S9-Engineering/samsung-t-series-bay/README.md

# S9 Monolith Bay — DIY 3D-Printable SSD Enclosure

### For Samsung T7, T7 Shield and T9

**Build your own** compact three-drive desktop SSD bay. Download the **STL and 3MF files**, 3D print the PLA parts and assemble an enclosure for **Samsung T7, T7 Shield and T9**, with interchangeable cartridges, passive ventilation and rear cable access.

<!-- project-version:start -->
**Version v1.0.2 · PLA · 8 printed components**
<!-- project-version:end -->

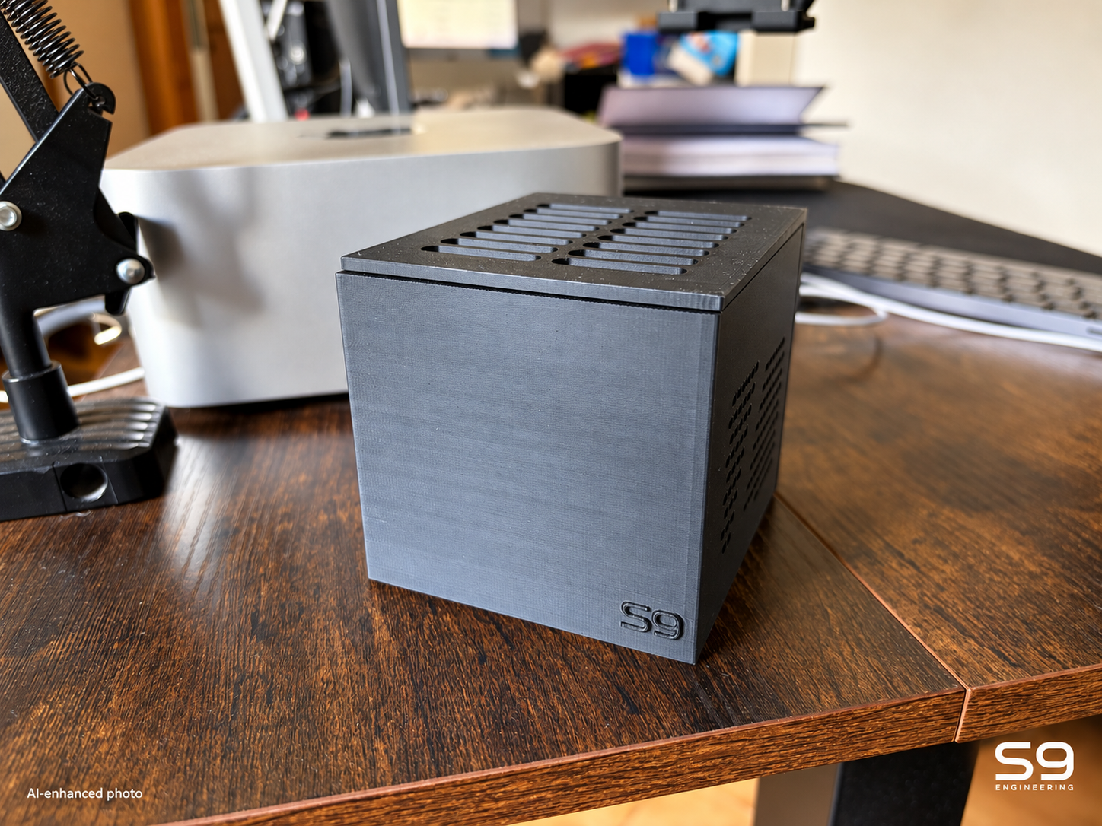
[picture p1: previews/photos/edited/bay-closed-enhanced.png]
Real printed S9 Monolith Bay closed on a wooden desk


*Photograph of the actual print, enhanced with AI for lighting and presentation. S9 Engineering signature at bottom right; “AI-enhanced photo” disclosure at bottom left.*

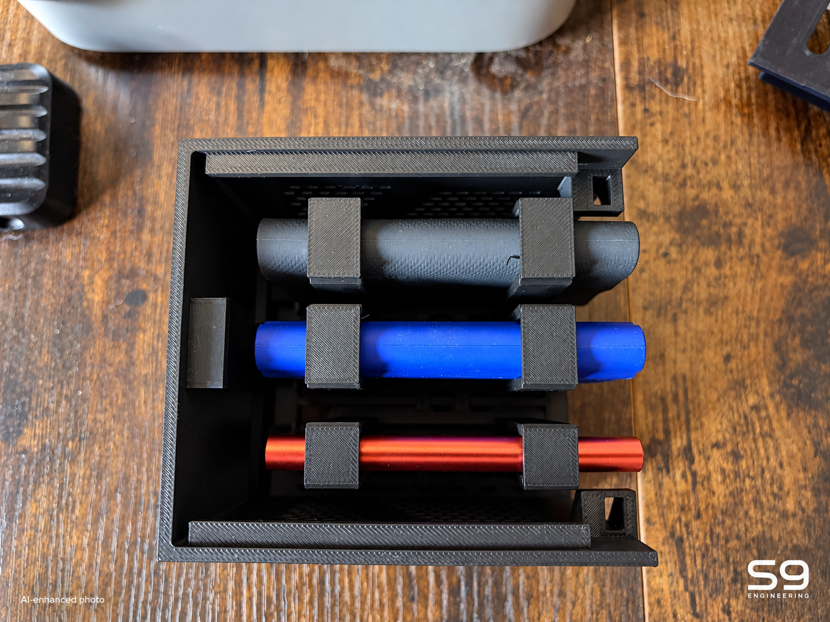
[picture p2: previews/photos/edited/bay-open-enhanced.png]
Actual open bay with three SSDs in their cartridges


*The photographed open enclosure with three installed SSDs. Lighting and presentation enhanced with AI; this is a physical sample rather than a generated product render.*

### Real-print reference photographs

All six photographs below show the author's actual print, with **no generative retouching**. These gallery copies preserve the original framing and printing details; full-resolution JPEG references are included in the repository. Location metadata has been removed from public copies.

| Closed bay | Open top view | Side ventilation |
| --- | --- | --- |
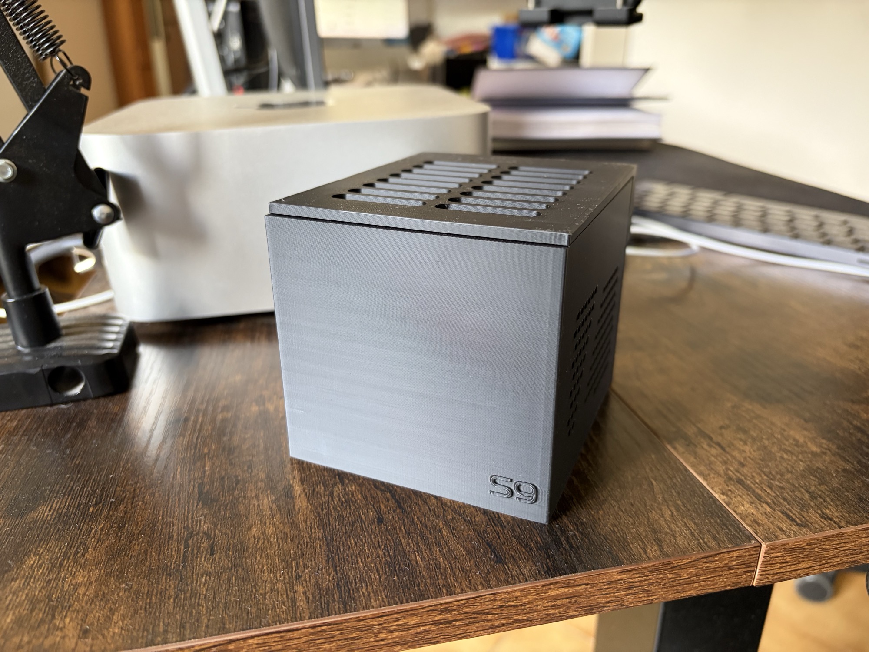
[picture p3: previews/photos/gallery/bay-closed.jpg]
Unretouched real print, closed
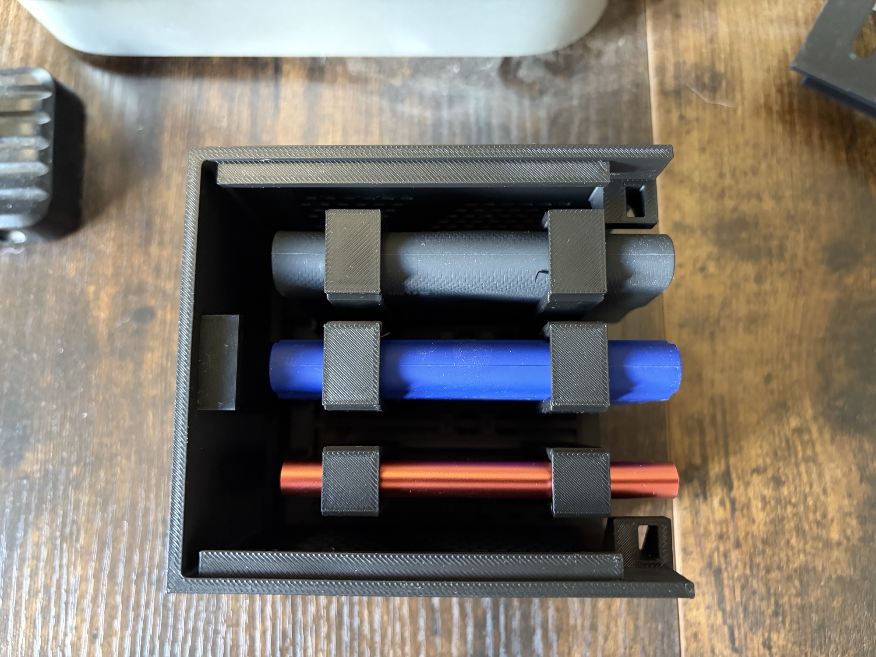
[picture p4: previews/photos/gallery/bay-open.jpg]
Unretouched real print, open
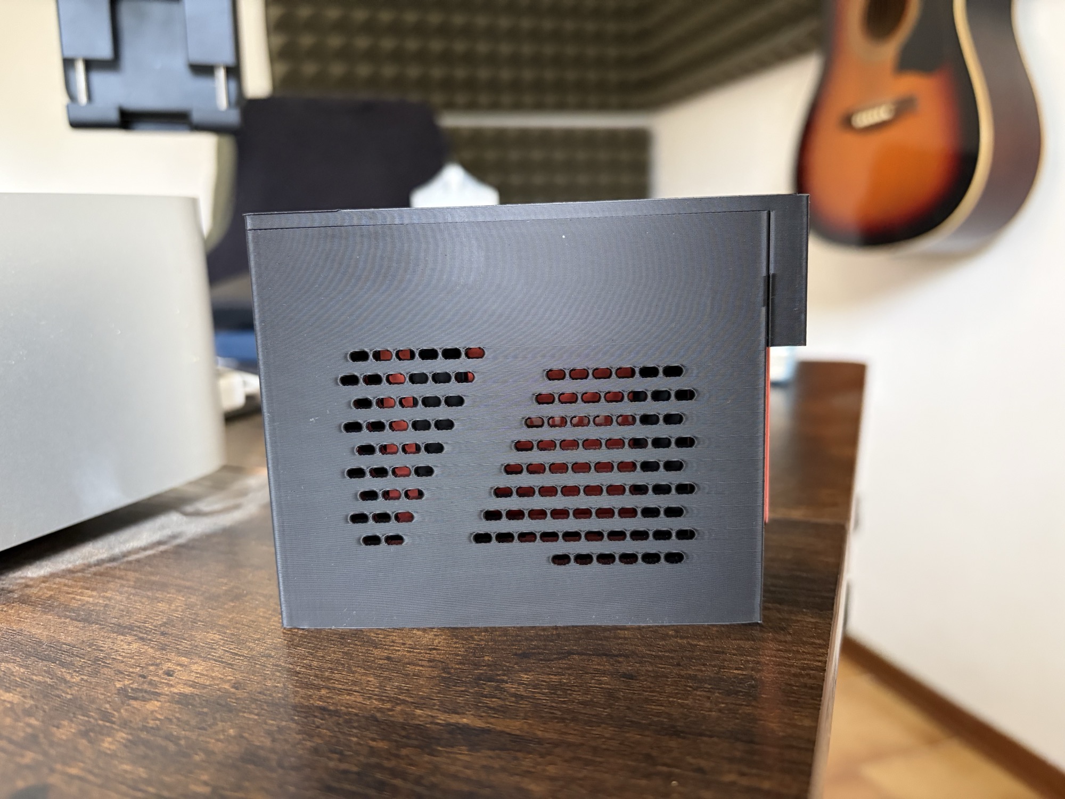
[picture p5: previews/photos/gallery/bay-side.jpg]
Real side ventilation
|  |  |  |

| Rear USB access | Open bay from the rear | Cartridge and stop detail |
| --- | --- | --- |
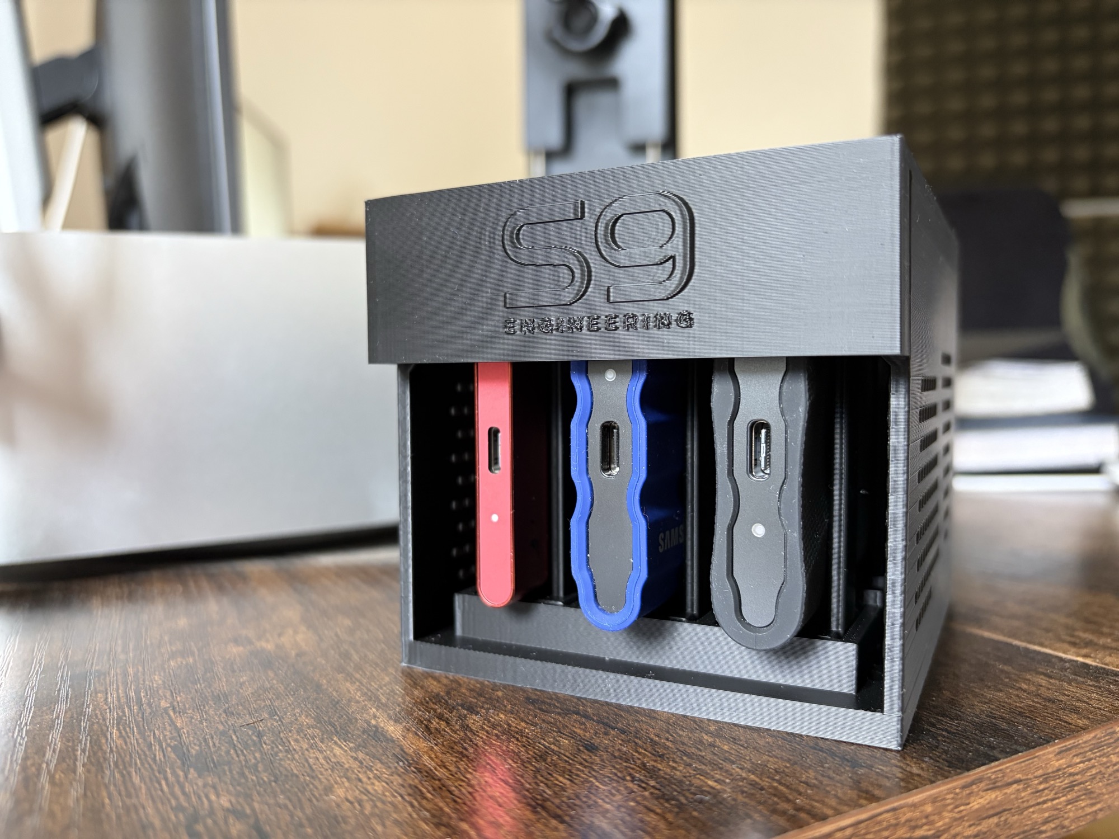
[picture p6: previews/photos/gallery/bay-rear.jpg]
Rear of the printed sample with its earlier branded lid
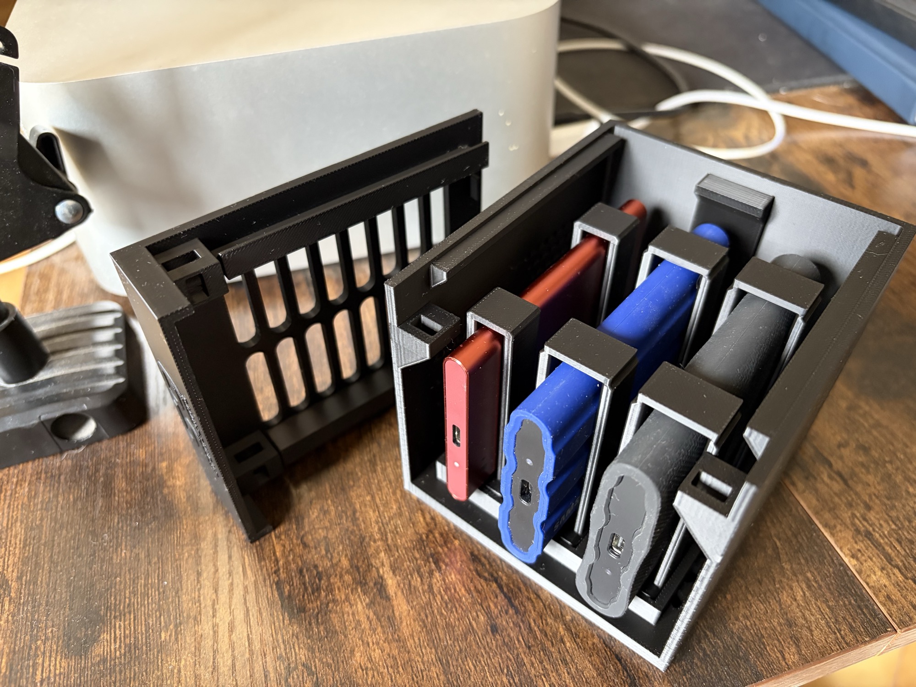
[picture p7: previews/photos/gallery/bay-open-rear.jpg]
Three SSDs and the removed lid
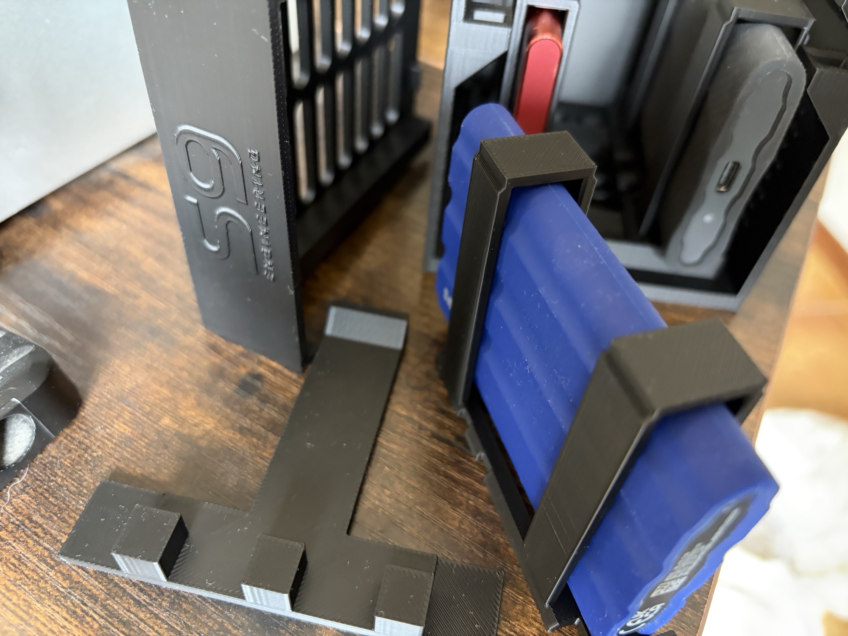
[picture p8: previews/photos/gallery/bay-cartridge-detail.jpg]
Blue SSD cartridge and the common three-block stop
|  |  |  |

*The photographed sample retains the earlier raised S9 Engineering rear lettering; the current downloadable lid has a plain rear tail.*

[Full-resolution photographs and enhanced alternatives](previews/photos/README.md) · [Photo treatment and provenance](previews/photos/edits.json).

## Product views

The following CAD illustrations show the current model and cable opening.

| Front | Side | Rear and cable access |
| --- | --- | --- |
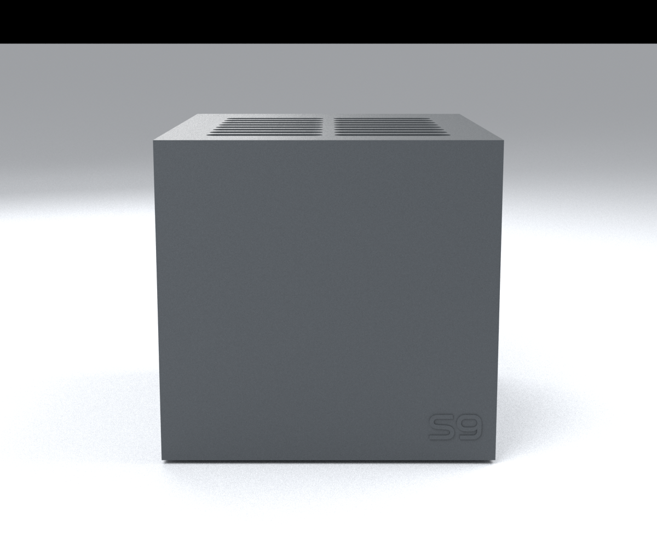
[picture p9: previews/renders/product-front.png]
Front with raised S9
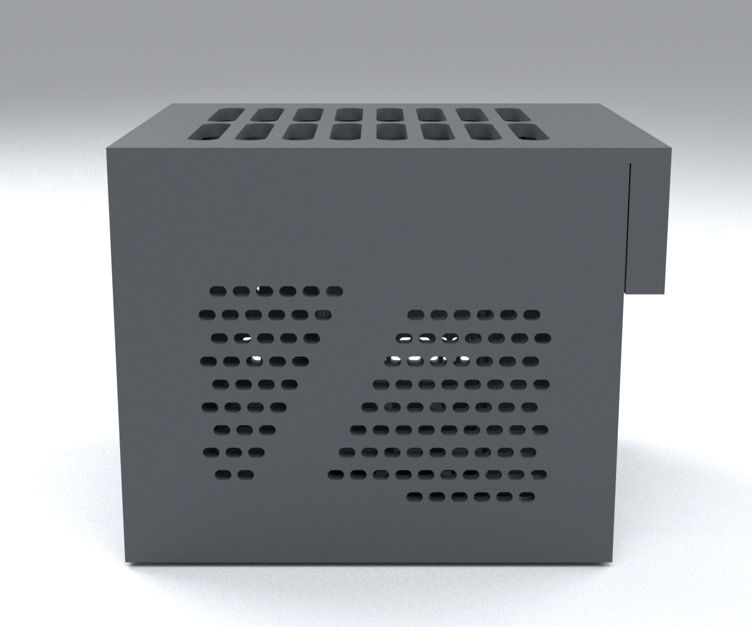
[picture p10: previews/renders/product-side.png]
Horizontal side ventilation
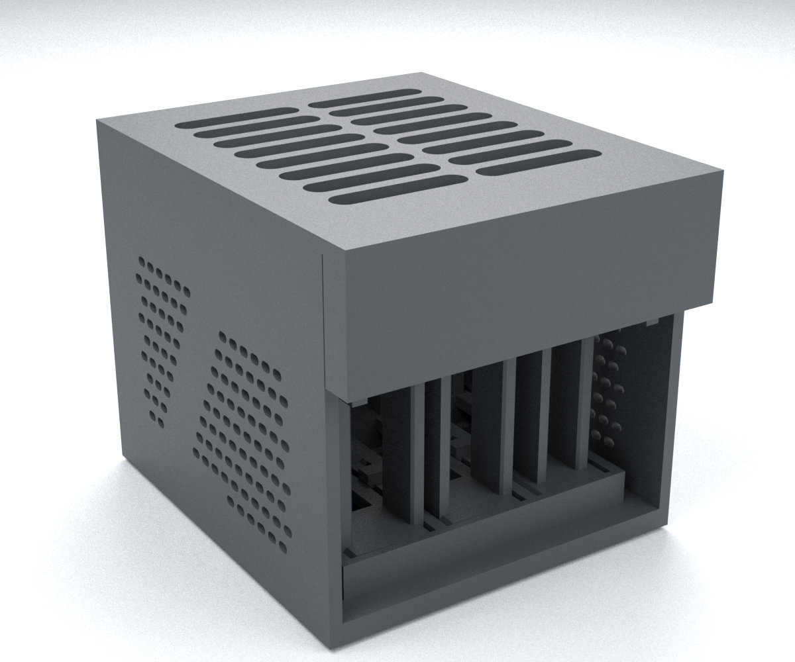
[picture p11: previews/renders/product-rear.png]
Plain rear tail and lower cable opening
|  |  |  |

## Compatibility and specifications

| Samsung portable SSD | Length × height × thickness | Cartridge |
| --- | --- | --- |
| **T7** | 85 × 57 × 8 mm | T7 cartridge included |
| **T7 Shield** | 88 × 59 × 13 mm | T7 Shield cartridge included |
| **T9** | 88 × 60 × 14 mm | T9 cartridge included |

Three drives stand side by side on their long edges, with their USB ports facing the open rear. Each of the three base positions accepts any of the included model-specific cartridges. The complete kit supplies one cartridge for each model above.

- **Overall size:** 90 × 109.4 × 86 mm (width × depth × height), excluding feet and external cables.
- **Enclosure:** sharp-edged monolithic shell, flat slotted roof and horizontal side ventilation pattern.
- **Cooling:** passive ventilation through the base, sides and top. Four rubber feet keep the bottom air inlets clear.
- **Access:** sliding roof on rigid guides, secured by two hidden quarter-turn pins. USB plugs and cable bends remain outside the enclosure.
- **Branding:** raised S9 on the front, 0.4 mm relief; plain rear tail.

## What you need

### For printing

- PLA filament in your chosen colour.
- Flush cutters or a deburring tool for removing the brim.

### For assembly

**8 printed components:**

| Printed component | Quantity | Print orientation / setting | STL |
| --- | ---: | --- | --- |
| Shell | 1 | Upright; 4 walls | [shell.stl](print/stl/shell.stl) |
| Sliding lid with rear tail | 1 | Exterior on the build plate; Arachne | [lid.stl](print/stl/lid.stl) |
| Hidden locking pin | 2 | Flat; 100% rectilinear infill | [locking-pin.stl](print/stl/locking-pin.stl) |
| Common front cartridge stop | 1 | Flat front face on the plate, three blocks up; 4 walls | [cartridge-stop.stl](print/stl/cartridge-stop.stl) |
| T7 cartridge | 1 | Upright frames; 6 walls | [cartridge-t7.stl](print/stl/cartridge-t7.stl) |
| T7 Shield cartridge | 1 | Upright frames; 6 walls | [cartridge-t7-shield.stl](print/stl/cartridge-t7-shield.stl) |
| T9 cartridge | 1 | Upright frames; 6 walls | [cartridge-t9.stl](print/stl/cartridge-t9.stl) |

| Additional item | Quantity | Specification |
| --- | ---: | --- |
| Rubber feet, including transparent types | 4 | Base fitting the Ø10.5 × 0.65 mm underside recesses, with enough projection to leave **at least 5 mm of air below the bay**. A nominal 6 mm foot height is a starting selection; match the actual foot to the recess. |
| Samsung SSDs | Up to 3 | T7, T7 Shield or T9, using the corresponding cartridge. |
| USB cables | One per drive | Matching cables for your SSDs and host, connected from the rear. |

For this replacement, reuse your existing feet, SSDs and cables; no new purchased fittings are needed. PLA BASIC is already in the author’s inventory. [Component sourcing checked 2026-10-25](verification/component-sourcing.json) records the current search limits; no dimensionally verified Amazon.it foot listing was found, so no substitute foot is endorsed.

Assembly is tool-free. There are **no screws, nuts, threaded inserts or internal adhesives**. If you choose self-adhesive rubber feet, their adhesive stays in the four exterior underside recesses. Feet, drives and cables are supplied separately; there is no internal USB hub.

## Download STL and 3MF files

1. Open [GitHub Releases](https://github.com/S9-Engineering/samsung-t-series-bay/releases) and choose the latest release. The current files also live in [print](print) and the [current print package](packages/monolith-bay-print-pack.zip).
2. Under **Assets**, download `monolith-bay-print-pack.zip` and `SHA256SUMS.txt`. Extract the ZIP and read its version-specific `README.md`. Use the matching complete file set. The original v1.0.0 release uses its original versioned asset names.
3. Import the [separate STLs](print/stl) into your slicer in **millimetres**, keeping their supplied orientations. Use the quantities listed above, including **two copies of the locking pin**.
4. Arrange the parts for your build plate, apply your printer and PLA profile with the part settings below, and inspect the slicing preview. The supplied [reference 3MF](print/slicer/full-kit-ecc2-pla-basic.3mf) already contains the one-plate layout and configuration described in **My setup**.
5. Print the parts, let the plate cool, and remove the brim and stray strings from the guides, cartridge openings and pin seats.

The full-kit and replacement 3MF files are complete native slicer projects with saved profiles, object overrides and sliced paths. Its optional G-code in `print/gcode/` is tied to the reference configuration below. Use the separate STLs to slice for your own equipment.

Before extraction, verify the downloaded ZIP with `shasum -a 256 -c SHA256SUMS.txt` from the download directory. Inside the extracted folder, the included `SHA256SUMS.txt` verifies the individual files with the same command. Earlier versions remain available on the Releases page with their original files.

### Replace only the stop and lid

If you already printed v1.0.0, reuse its shell, all cartridges and both pins. Choose one of these alternative layouts; printing all of them would duplicate parts.

| Layout | Native 3MF | Reference slicer estimate |
| --- | --- | --- |
| Stop only | [stop-ecc2-pla-basic.3mf](print/slicer/stop-ecc2-pla-basic.3mf) | 31 min 23 s / 9.54 g |
| Plain rear lid only | [lid-ecc2-pla-basic.3mf](print/slicer/lid-ecc2-pla-basic.3mf) | 2 h 11 min 19 s / 39.58 g |
| Stop and lid together | [both-ecc2-pla-basic.3mf](print/slicer/both-ecc2-pla-basic.3mf) | 2 h 40 min 48 s / 48.59 g |

The stop prints flat on its front face with the three blocks facing up. Remove the brim from the contact edges, lower the stop into the existing shell and check that the cartridge tongues remain blocked throughout its small side movement. No new purchased fittings are needed for this update.

## My setup

This is the reference configuration used to prepare the included 3MF and G-code. You can use the separate STLs with your own printer and material profile.

| Item | What I used |
| --- | --- |
| Printer | ELEGOO Centauri Carbon 2 Combo |
| Printer profile | Elegoo Centauri Carbon 2 0.4 nozzle; 256 × 256 mm plate with the profile's excluded corner |
| Nozzle | 0.4 mm |
| Build plate | Textured PEI |
| Filament | ELEGOO PLA BASIC, 1.75 mm, one colour/channel |
| Slicer | ElegooSlicer 1.5.3.5, engine 2.4.2 |
| PLA enclosure setup | Front door open |
| Reference layout | All 8 printed components on one plate |
| Slicer estimate for this setup | 12 h 23 min 19 s / 213.41 g, including brim; one material, no purge tower |

| Print setting | My value |
| --- | --- |
| Layer height | 0.20 mm |
| Walls | 4 general; 6 on the drive cartridges |
| Infill | 20% gyroid; pins 100% rectilinear |
| Wall generator | Arachne on the lid |
| Nozzle / textured PEI bed | 220 °C / 60 °C |
| Volumetric flow limit / bridge speed | 5 mm³/s / 25 mm/s |
| Brim | Outer, 5 mm; 0.10 mm separation |
| Elephant-foot compensation | 0.10 mm |
| Supports / raft / fuzzy skin | Disabled |

The saved project retains the slicer warning `bed_temperature_too_high_than_filament` for the 60 °C bed setup; keep the front door open as listed above. No other slice warning was accepted.

These are the saved reference values. Temperature, flow and the plate layout should follow your own printer/material configuration when you reslice. The time and consumption above are slicer estimates for this setup.

## How to assemble

Gold and blue in the following images distinguish the pieces; the print project uses a single PLA colour. Drive shapes are schematic envelopes.

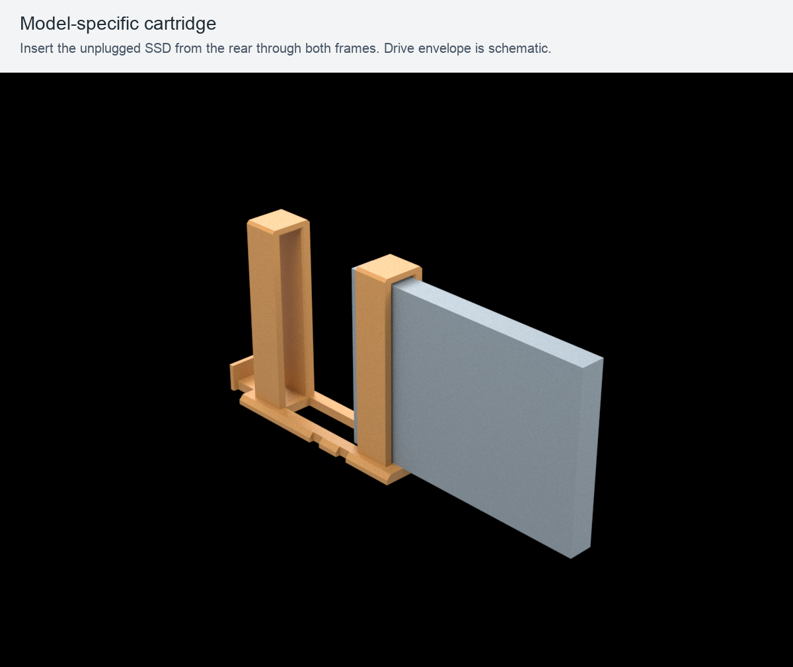
[picture p12: previews/assembly/02-drive-cartridge.png]
Drive entering a model-specific cartridge from the rear


### Load the cartridges

1. With the USB cable unplugged, slide each drive **from the rear through both frames** of its matching cartridge: T7, T7 Shield or T9. The USB port faces the rear.
2. Choose the cartridge's position in the bay. The three base positions share the same interface, so any included cartridge can occupy any position.

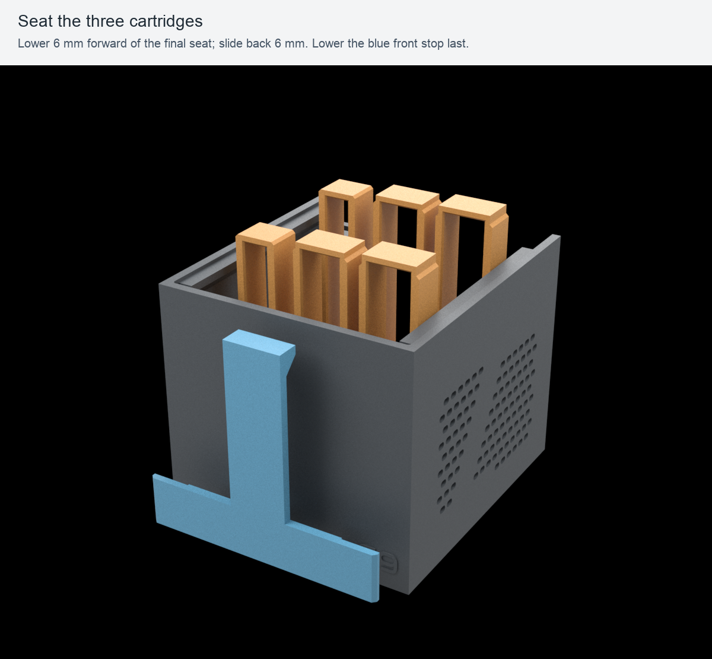
[picture p13: previews/assembly/03-cartridge-seating.png]
Three cartridges and the common front stop above the shell


### Seat the cartridges

3. Hold each cartridge **6 mm forward** of its final position, lower its foot into the base, then slide it **6 mm towards the rear** under the four short rigid tabs.
4. Lower the **83.5 mm common front stop** into the gap between the front wall and the cartridge feet, with its three lower blocks pointing towards the cartridge tongues. It rests on the floor beside the feet; nothing goes underneath them. The nominal side travel is **0.50 mm total**. The added ends clear the internal corner radii and upper roof guides; lift it straight up using the original handle.
5. Fit the four rubber feet in the underside recesses, leaving at least 5 mm of air under the base and keeping the bottom slots unobstructed.

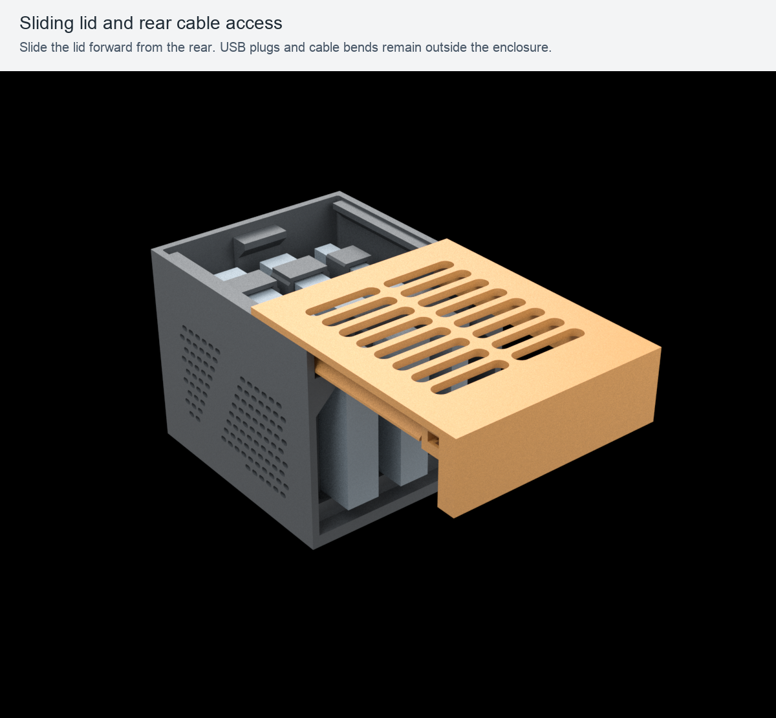
[picture p14: previews/assembly/04-slide-lid.png]
Roof sliding forward along its guides with rear connector access open


### Connect and close

6. Connect the USB cables through the rear opening. Keep the plugs and cable bends outside the enclosure, clear of the rear tail.
7. Slide the lid forward from the rear until fully seated in both guides. Leave approximately **110 mm behind the bay** for roof removal, plus space for the natural cable bend.

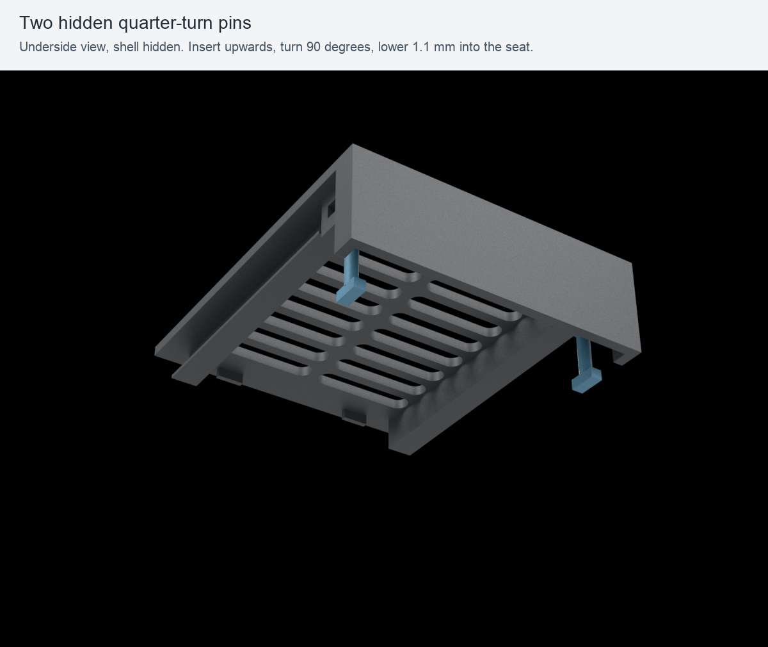
[picture p15: previews/assembly/05-locking-pins.png]
Underside of the lid showing its two hidden locking pins


8. Insert each pin **from below**, turn it **90°**, then lower it **1.1 mm** into its seat. The two receivers are mirrored; turn each pin in the direction that seats its crossbar. Both pins are identical printed parts. The image hides the shell so the locking arrangement is visible.
9. Place the bay upright on the desk with the ventilation openings clear and the cables relaxed.

### Open or remove a drive

10. Lift each pin **1.1 mm**, turn it back and remove it. Remove **both** pins before sliding the roof rearward.
11. Unplug the drive cable, lift the common front stop by its handle, slide the cartridge forward **6 mm**, and lift it out. Slide the drive out of its cartridge from the rear.

## Editable CAD and versioning

The working tree contains one current model family: [STL](print/stl), [STEP](cad), [native print projects](print/slicer), [editable CAD](source/generate.py), [parameters](source/parameters.json) and [verification](verification/geometry.json). Device-specific cartridges are functional variants of the same kit.

`VERSION` is the only project version counter. Every normal push to `main` prepares the next patch version, validates the saved artifact evidence, builds the print ZIP, commits version/package updates, and publishes an immutable matching Git tag and GitHub Release. Set a higher minor/major value in `VERSION` explicitly when needed; no parallel Rxx numbering is used. Source changes without matching regenerated files/evidence fail the release checks. Branch pushes do not release.

Use Git commits for history, branches for development, and tagged releases for distributed kits. Earlier snapshots remain recoverable from Git; published tags and release assets are unchanged. Component files use stable English names. Use all files from the same tag when printing a distributed kit.

```sh
python3.11 -m venv .venv-cad
.venv-cad/bin/pip install -r source/requirements.txt
.venv-cad/bin/python source/generate.py
.venv-cad/bin/python source/verify.py
```

The generator exports assembled and print-oriented STEP files, oriented STL files and an assembly manifest. Printing projects retain their already-checked machine configuration; run `.venv-cad/bin/python source/slice.py` after geometry verification to regenerate the native projects and real G-code. [Geometry checks](verification/geometry.json) also compare the current stop and lid with the accepted cartridge-stop and lid geometry. No thermal or endurance test is claimed.

## License and attribution

Original project designs and documentation are licensed under **CC BY-NC-SA 4.0** ([LICENSE.txt](LICENSE.txt)). Original S9 software, including CAD generators and build/render scripts, is licensed under **PolyForm Noncommercial 1.0.0** ([LICENSE-SOFTWARE.txt](LICENSE-SOFTWARE.txt)). Read [LICENSING.md](LICENSING.md) for scope, required notices, separate commercial permissions, S9 branding and third-party exclusions. The software is source-available; generated models retain their separately stated design license.

The license grants include covered original material in **v1.0.0** and original software in Git history and release source archives. The original published archive predates these notices and remains unchanged; historical statements that no license was selected or software terms were undecided are superseded by the current grants in LICENSING.md. Current print packages include both license texts and the scope notice.

Samsung names identify compatible devices; this is an independent enclosure design with no claim of manufacturer affiliation.
