S9-Engineering/samsung-t-series-bay/previews/photos/prompts.md

# Real-print photo enhancement prompts

Prepared on 2026-10-26 with the built-in image_gen tool. These are edits of supplied photographs, not new product renders. Both covers are disclosed as **AI-enhanced photo**. Full-resolution, unretouched JPEG references are retained alongside the presentation images.

## Closed bay

Use case: lighting-weather. Edit target: image 1, a REAL photograph of a charcoal PLA 3D-printed S9 Monolith Bay on a wooden desk. Image 2 is ONLY the approved S9 Engineering branding reference, never a product reference. Deliver one faithful polished photographic cover at landscape 4:3 aspect ratio. Keep the exact original camera angle, crop, object silhouette and proportions, sharp enclosure corners, lid seam, every top ventilation slot and all side ventilation openings EXACTLY as photographed. Keep the small raised S9 logo on the actual front at its existing size, shape and placement. Preserve all real FDM layer lines, top extrusion lines, minor print imperfections, specks and surface irregularities; do not smooth, retouch, rebuild or redraw the physical object. Make only restrained exposure, white balance and local shadow adjustments so this dark grey printed object reads clearly, without becoming lighter material, metallic or glossy. Keep the original wooden desk, computer, keyboard, blurred room and microphone arm; preserve depth of field and contact shadows. NO new props, NO imaginary SSDs, NO geometry modification, NO beautifying away print defects. At bottom right, in the wooden desk margin clear of the object, add a very small crisp S9 ENGINEERING signature using the exact logo design in image 2 (white artwork only, no rectangular background), with comfortable edge margins. At bottom left add tiny readable text exactly: 'AI-enhanced photo'. The result must remain recognisably this same real photograph, not a CGI reconstruction.

## Open bay

Use case: lighting-weather. Edit target: image 1, a REAL top-down photograph of the open S9 Monolith Bay with three actual SSDs fitted in printed cartridges. Image 2 is ONLY the approved S9 Engineering branding reference. Produce a faithful photographic enhancement, landscape 4:3. Preserve the EXACT original perspective, crop and product pixels' structure: all three actual drives in their current positions and colours (black/grey top, blue middle, slim orange-red bottom); exactly two printed retaining frames around each drive; front wall at left, open cable side at right, both roof guide rails and square receivers at right, common front stop at left. Keep the existing opening count, cartridge frame dimensions, drive edges, printed layer lines and extrusion texture, imperfections, contact shadows and gaps. Never invent a fourth drive, never replace the cartridges, never close the open enclosure or alter a printed part. Adjust only modest exposure, natural white balance and light/shadow clarity. Preserve wooden desktop, out-of-focus items at image borders and realistic camera optics. Do not replace or clean up the physical object's surface, do not create a render. Add a very small white S9 ENGINEERING signature using the supplied exact logo design (no background box) at bottom right on the desk margin, clear of the enclosure, and tiny text 'AI-enhanced photo' at bottom left. Keep both marks subtle with clear edge margins.
