S9-Engineering/samsung-t-series-bay/previews/photos/README.md

# Photographs of the printed S9 Monolith Bay

The author supplied these six real photographs. The reference JPEGs contain no generative retouching: HEIC captures were converted at full resolution, with location metadata removed without changing the JPEG's decoded pixels. The smaller gallery copies retain the full framing at 2000 × 1500 pixels.

| View | Gallery photograph | Full-resolution reference | AI-enhanced alternative |
| --- | --- | --- | --- |
| Closed bay | [View](gallery/bay-closed.jpg) | [JPEG](edited/bay-closed-real.jpg) | [PNG](edited/bay-closed-enhanced.png) |
| Open top view | [View](gallery/bay-open.jpg) | [JPEG](edited/bay-open-real.jpg) | [PNG](edited/bay-open-enhanced.png) |
| Side ventilation | [View](gallery/bay-side.jpg) | [JPEG](edited/bay-side-real.jpg) | [PNG](edited/bay-side-enhanced.png) |
| Rear USB access | [View](gallery/bay-rear.jpg) | [JPEG](edited/bay-rear-real.jpg) | [PNG](edited/bay-rear-enhanced.png) |
| Open rear view | [View](gallery/bay-open-rear.jpg) | [JPEG](edited/bay-open-rear-real.jpg) | [PNG](edited/bay-open-rear-enhanced.png) |
| Cartridge and stop detail | [View](gallery/bay-cartridge-detail.jpg) | [JPEG](edited/bay-cartridge-detail-real.jpg) | [PNG](edited/bay-cartridge-detail-enhanced.png) |

The photographed build retains the earlier raised **S9 Engineering** rear lettering. The current downloadable lid has a plain rear tail. The photographs show that physical sample without altering its components to match a later CAD revision.

## Preservation and treatment

Untouched HEIC captures remain local because they contain GPS coordinates. Their narrow ignore rules keep those files out of public Git history. The full-resolution public JPEGs, gallery copies, enhanced images and [provenance](edits.json) are versioned in this repository.

Enhanced alternatives were prepared with the built-in image tool for restrained lighting and presentation changes, with an S9 Engineering signature and an **AI-enhanced photo** label. Reference photographs retain the actual surface texture and print imperfections. [Initial prompts](prompts.md) and [additional prompts](additional-prompts.json) document the treatments.

Channel-specific exports and upload ZIPs remain local, separate from these GitHub assets.
