S9-Engineering/samsung-t-series-bay/assets/cover-references/closed-cad.png

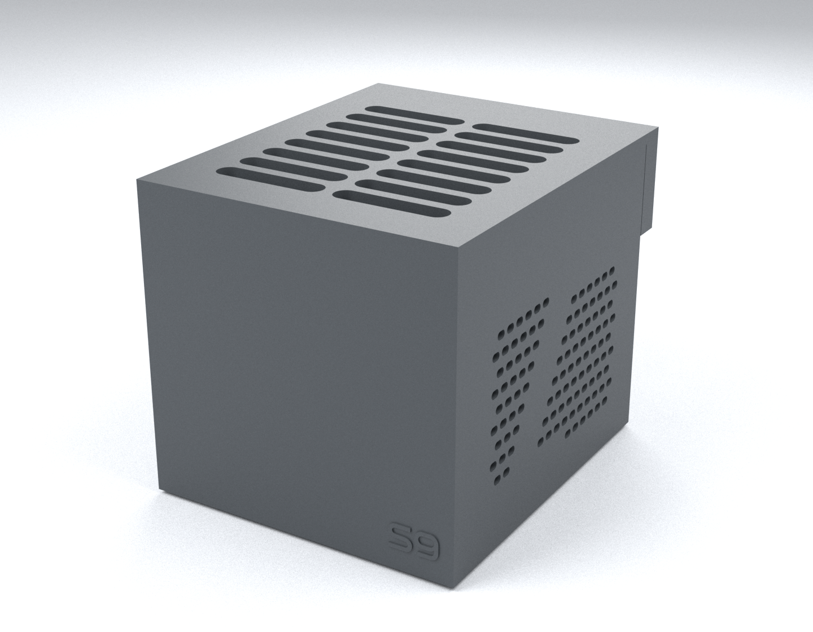
assets/cover-references/closed-cad.png
