S9-Engineering/samsung-t-series-bay/assets/cover-references/open-cad.png

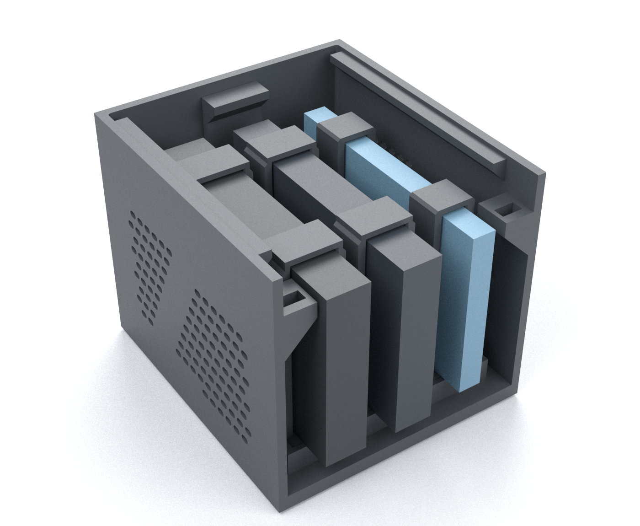
assets/cover-references/open-cad.png
