S9-Engineering/samsung-t-series-bay/assets/cover-references/photoreal-v2-pass1.png

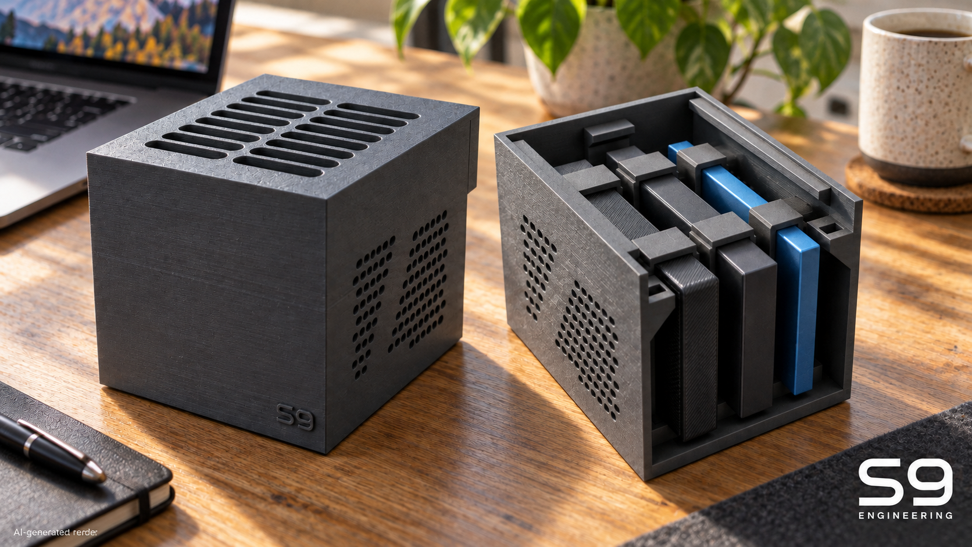
assets/cover-references/photoreal-v2-pass1.png
