S9-Engineering/samsung-t-series-bay/previews/photos/edited/bay-cartridge-detail-enhanced.png

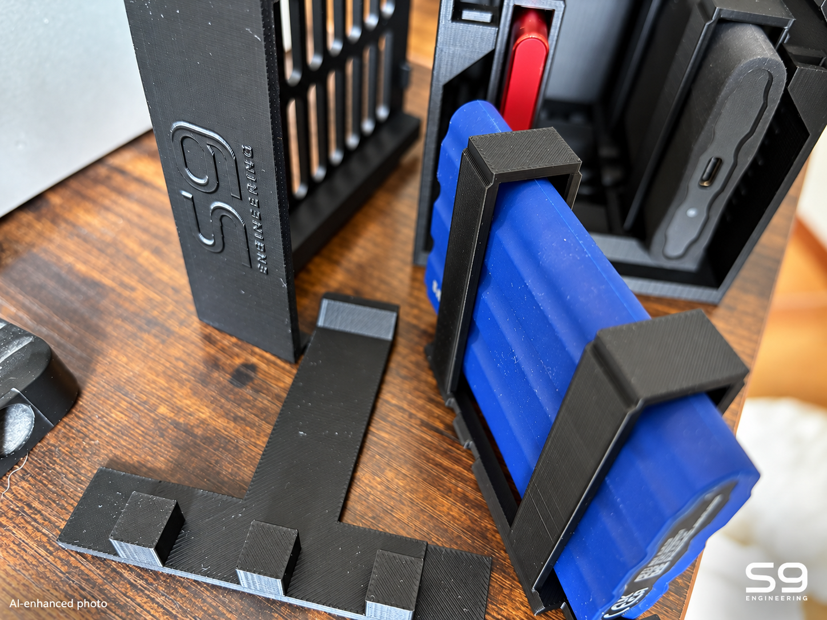
previews/photos/edited/bay-cartridge-detail-enhanced.png
