S9-Engineering/samsung-t-series-bay/previews/photos/edited/bay-rear-enhanced.png

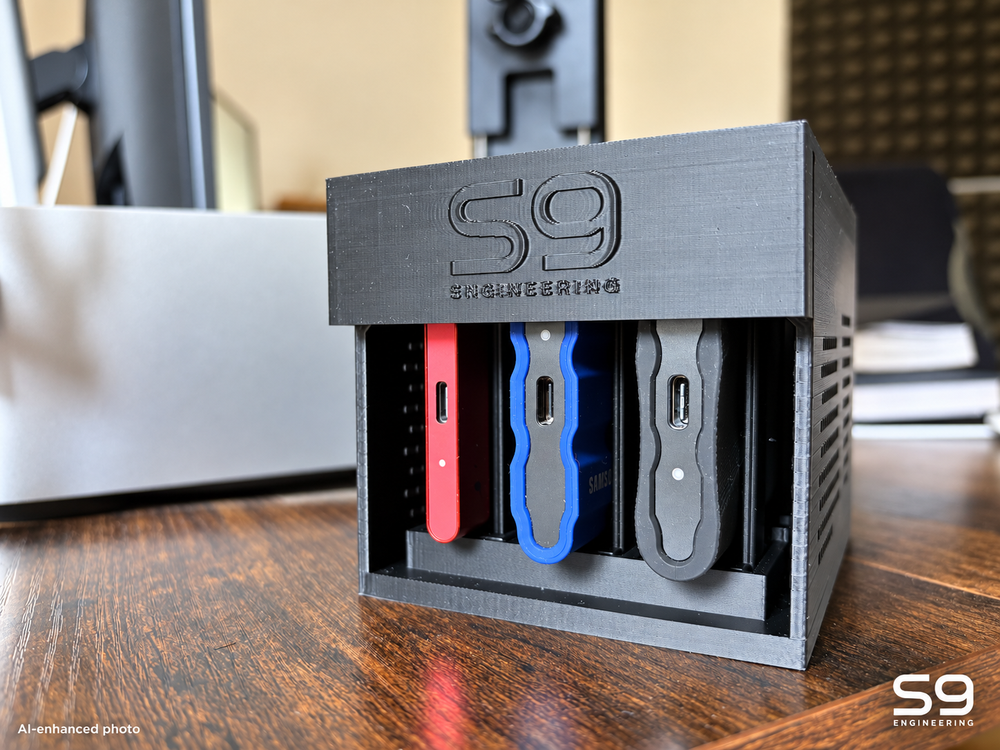
previews/photos/edited/bay-rear-enhanced.png
