S9-Engineering/samsung-t-series-bay/previews/renders/hero-desk-closed-open.png

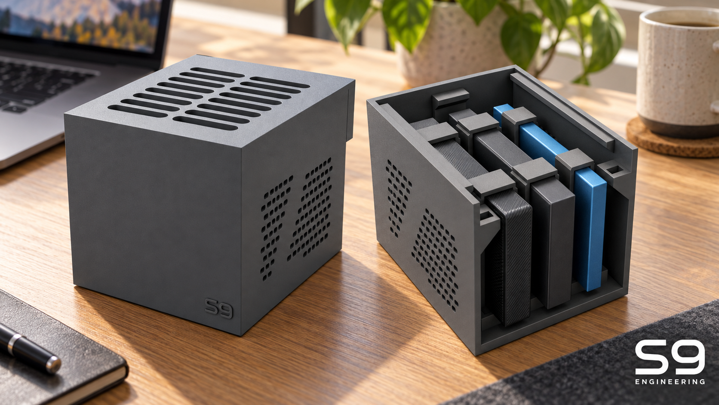
previews/renders/hero-desk-closed-open.png
