S9-Engineering/samsung-t-series-bay/verification/slicing/both/review-overview.png

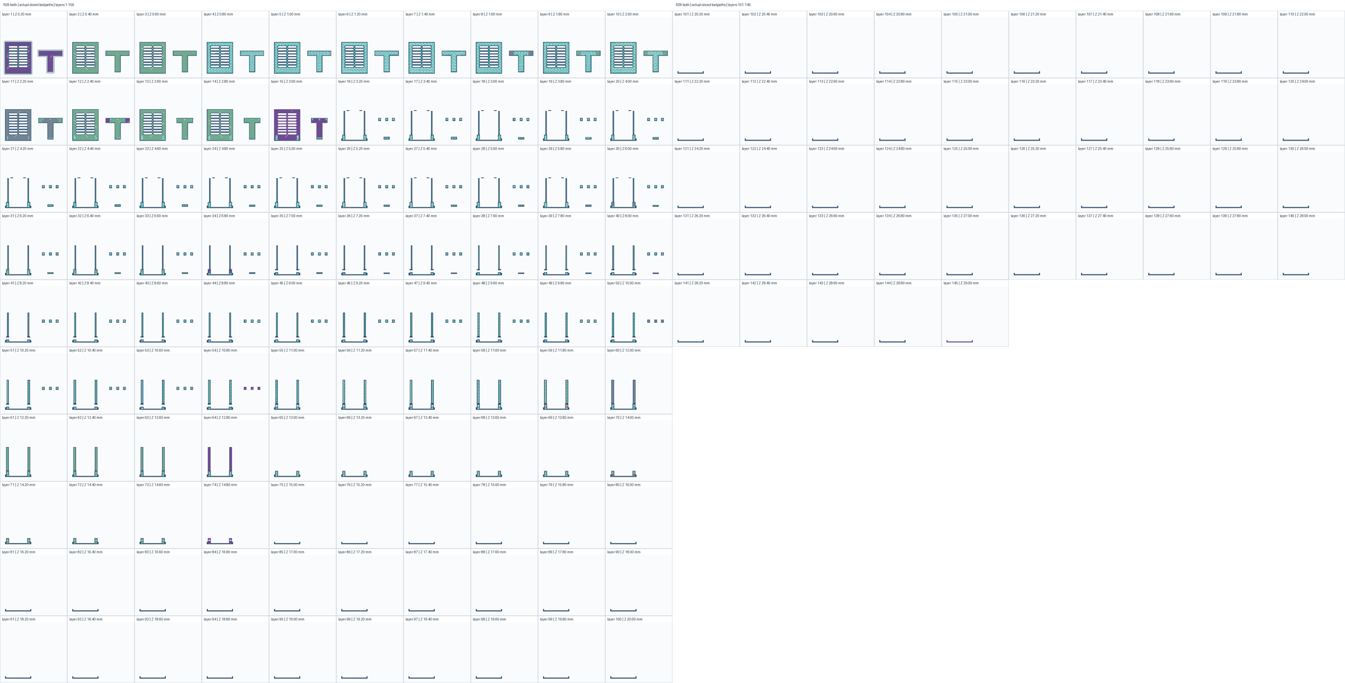
verification/slicing/both/review-overview.png
