S9-Engineering/samsung-t-series-bay/verification/slicing/lid/review-overview.png

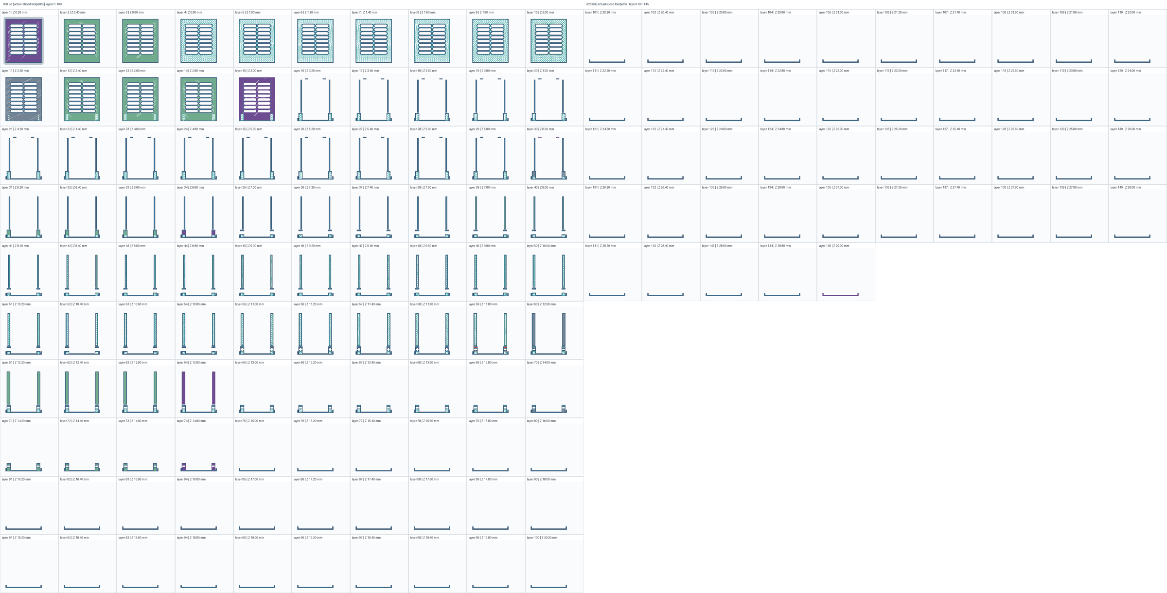
verification/slicing/lid/review-overview.png
