S9-Engineering/samsung-t-series-bay/verification/slicing/stop/review-overview.png

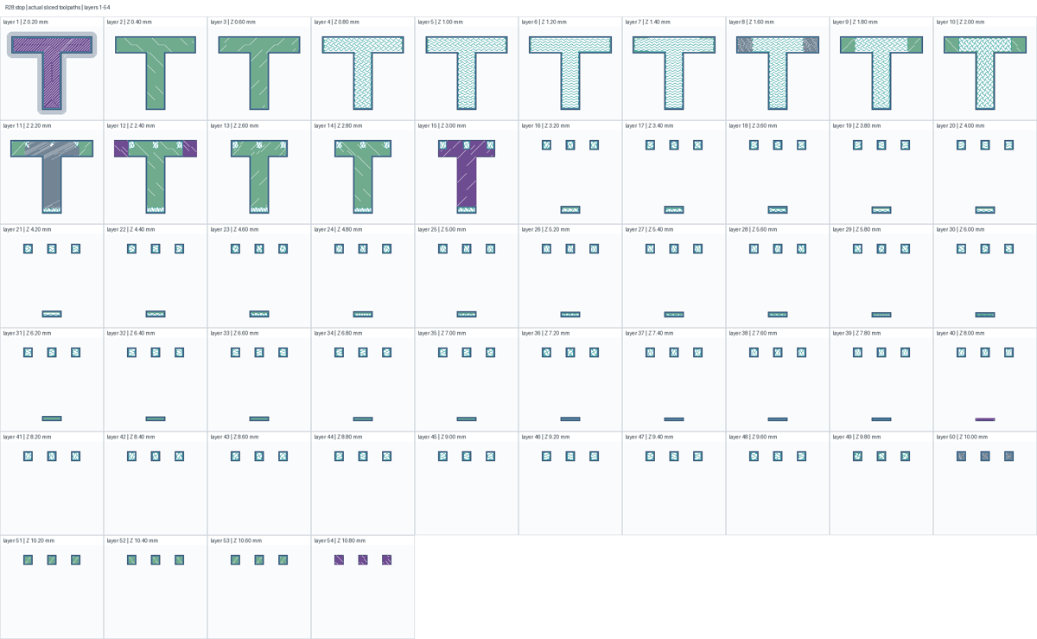
verification/slicing/stop/review-overview.png
