S9-Engineering/samsung-t-series-bay/print/slicer/full-kit-ecc2-pla-basic.3mf

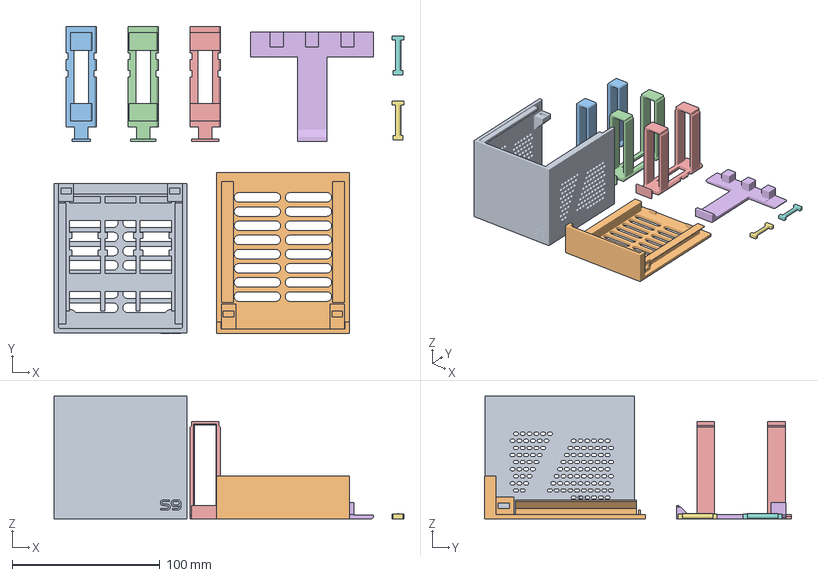
[picture p25: CAD file, 2026-10-25]
print/slicer/full-kit-ecc2-pla-basic.3mf
237.0 x 207.7 x 83.0 mm
Sliding lid
Cartridge t7
Cartridge t7-shield
Cartridge t9
Cartridge stop
Locking pin 1
Locking pin 2
