S9-Engineering/samsung-t-series-bay/cad/reference-assembly-do-not-print.step

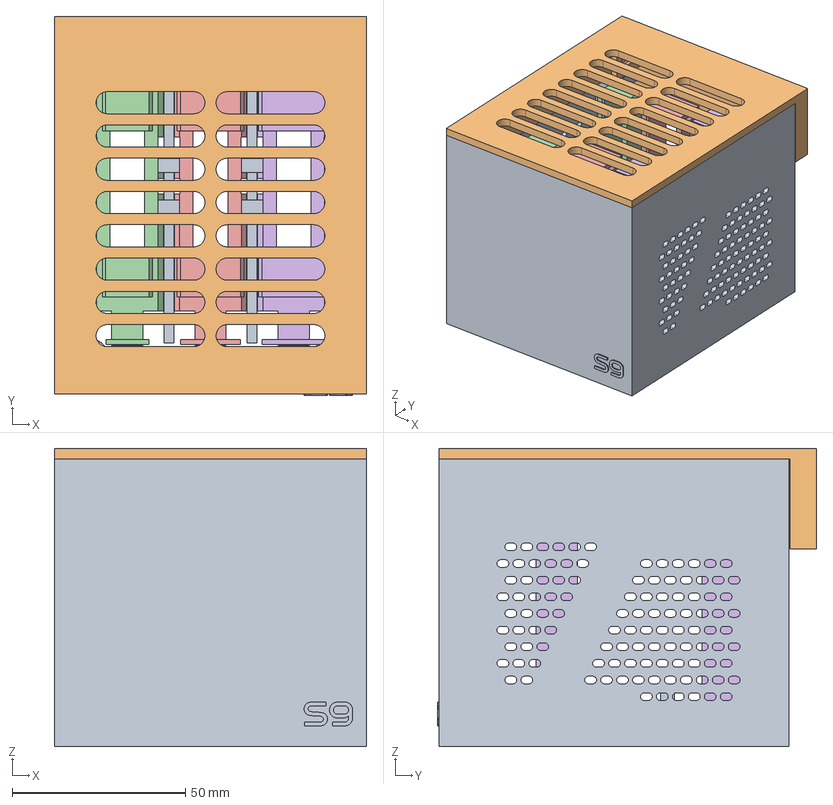
[picture p26: CAD file, 2026-10-25]
cad/reference-assembly-do-not-print.step
90.0 x 109.4 x 86.0 mm
lid
cartridge-stop
cartridge-t7
cartridge-t7-shield
cartridge-t9
locking-pin-1
locking-pin-2
