S9-Engineering/samsung-t-series-bay/cad/locking-pin.step

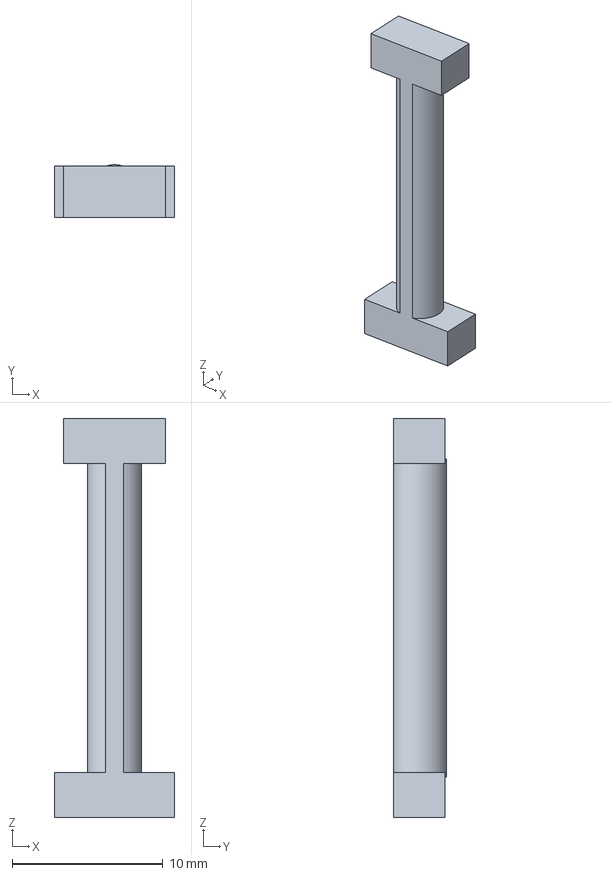
[picture p27: CAD file, 2026-10-25]
cad/locking-pin.step
8.00 x 3.50 x 26.5 mm
