S9-Engineering/samsung-t-series-bay/cad/print/shell.step

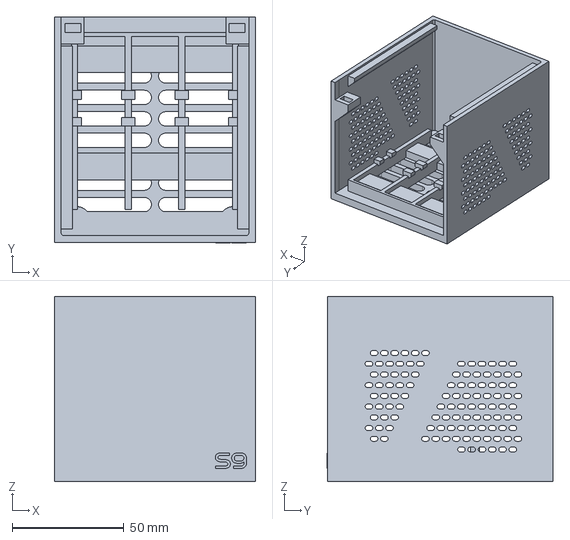
[picture p28: CAD file, 2026-10-25]
cad/print/shell.step
90.0 x 101.4 x 83.0 mm
