S9-Engineering/samsung-t-series-bay/verification/meshes/cartridge-stop.ply

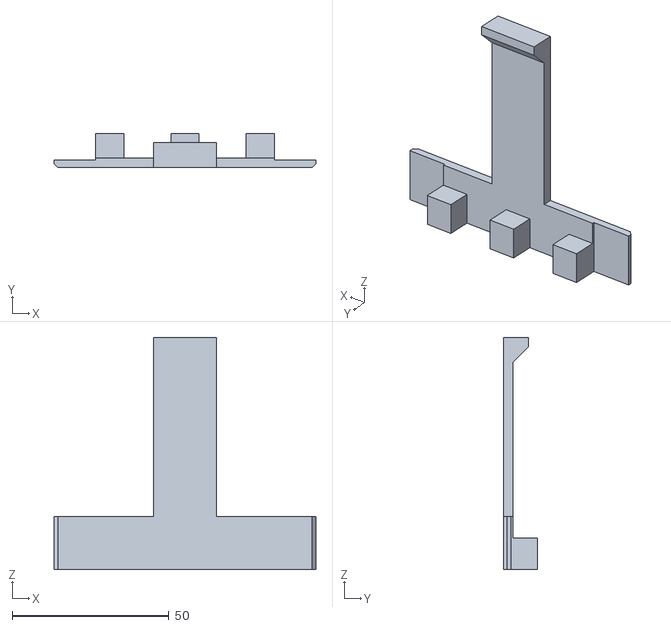
[picture p29: CAD file, 2026-10-25]
verification/meshes/cartridge-stop.ply
83.5 x 10.9 x 74.0
