S9-Engineering/samsung-t-series-bay/verification/slicing/both/both-geometry.3mf

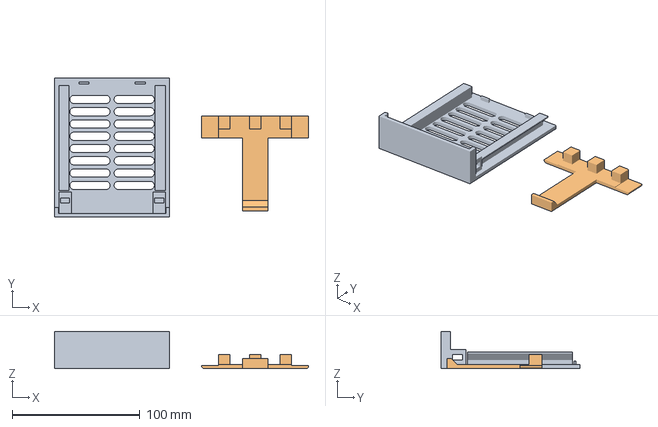
[picture p30: CAD file, 2026-10-25]
verification/slicing/both/both-geometry.3mf
198.5 x 109.0 x 29.0 mm
Sliding lid
Cartridge stop
