S9-Engineering/samsung-t-series-bay/verification/slicing/lid/lid-geometry.3mf

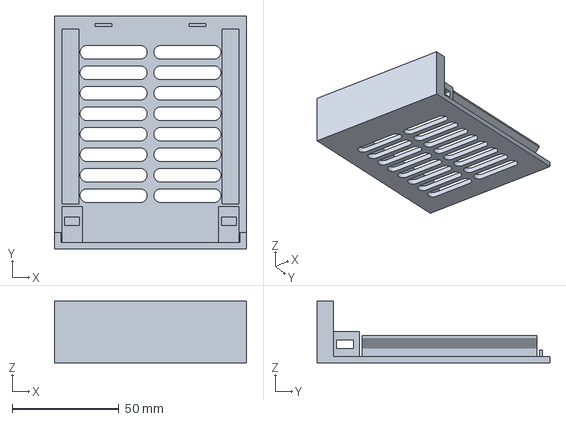
[picture p31: CAD file, 2026-10-25]
verification/slicing/lid/lid-geometry.3mf
90.0 x 109.0 x 29.0 mm
