S9-Engineering/samsung-t-series-bay/cad/cartridge-t9.step

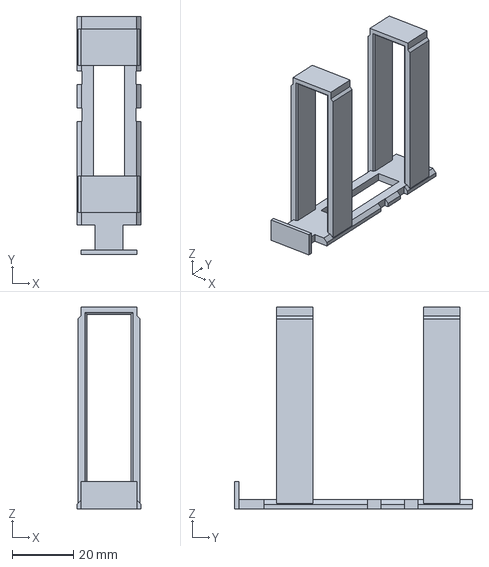
[picture p32: CAD file, 2026-10-25]
cad/cartridge-t9.step
20.8 x 77.7 x 65.9 mm
