S9-Engineering/samsung-t-series-bay/cad/cartridge-t7-shield.step

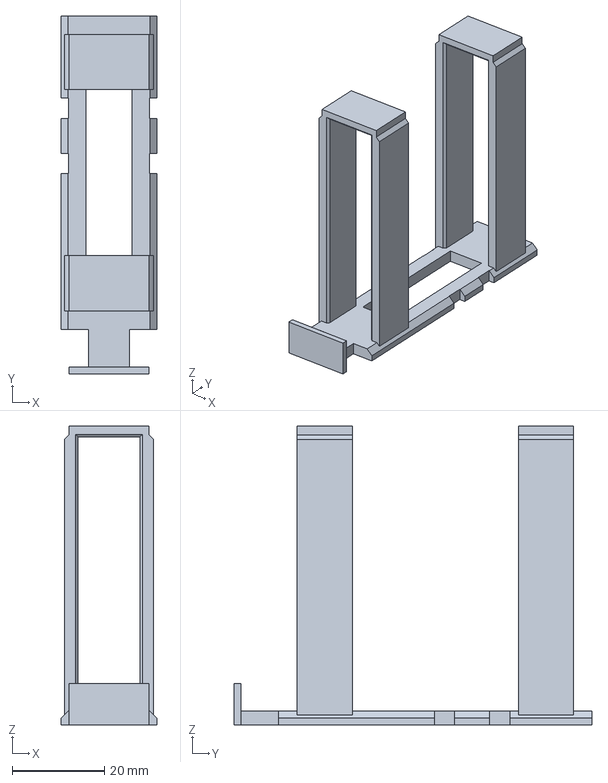
[picture p33: CAD file, 2026-10-25]
cad/cartridge-t7-shield.step
20.8 x 77.7 x 64.9 mm
