S9-Engineering/samsung-t-series-bay/verification/meshes/fit-shell.ply

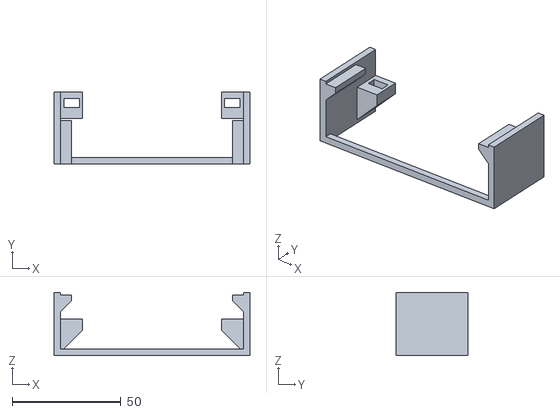
[picture p34: CAD file, 2026-10-24]
verification/meshes/fit-shell.ply
90.0 x 33.0 x 29.0
