S9-Engineering/samsung-t-series-bay/print/slicer/01-fit-coupon-ecc2-pla-basic.3mf

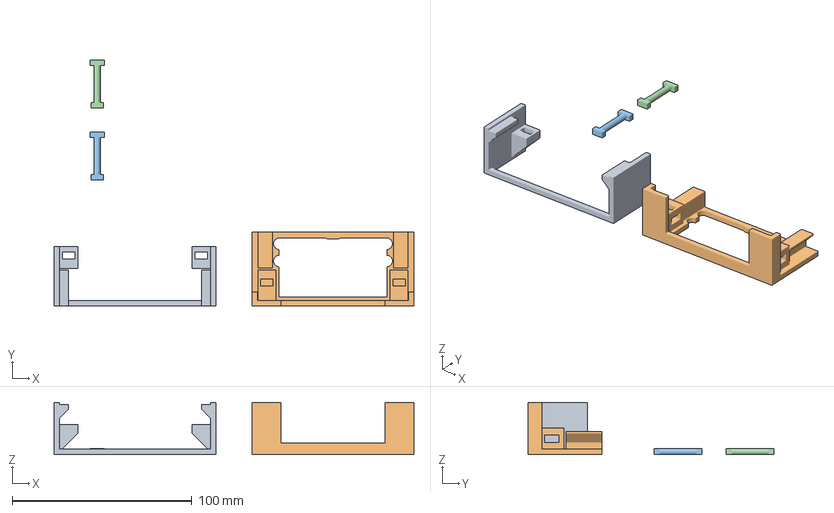
[picture p35: CAD file, 2026-10-24]
print/slicer/01-fit-coupon-ecc2-pla-basic.3mf
200.0 x 136.5 x 29.0 mm
PROVINO_GUIDE_SCOCCA_R27
PROVINO_GUIDE_TETTO_R27
PERNO_R27_SX
PERNO_R27_DX
