S9-Engineering/samsung-t-series-bay/cad/cartridge-t7.step

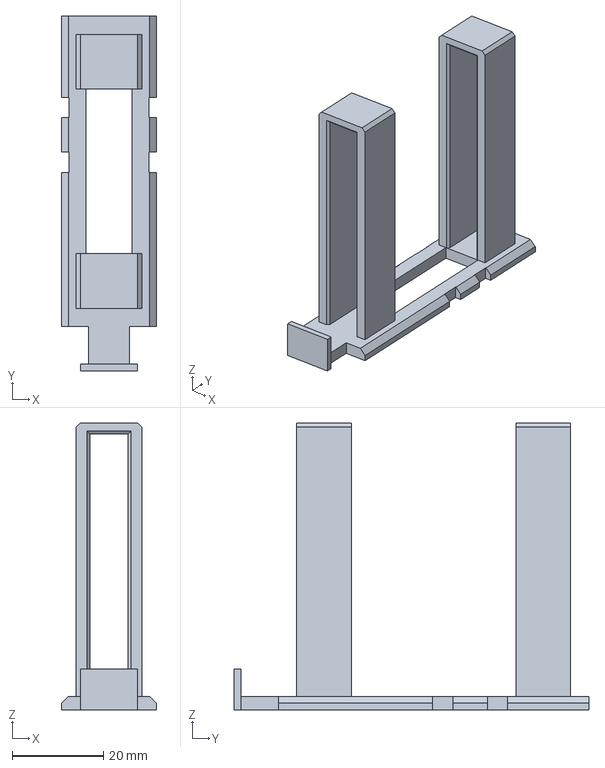
[picture p36: CAD file, 2026-10-25]
cad/cartridge-t7.step
20.8 x 77.7 x 62.9 mm
