S9-Engineering/samsung-t-series-bay/verification/meshes/fit-lid.ply

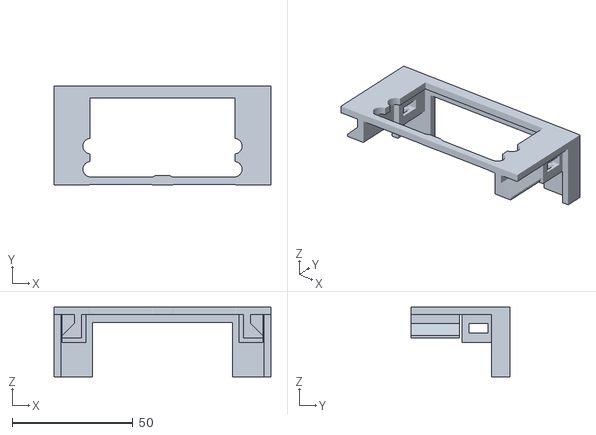
[picture p37: CAD file, 2026-10-24]
verification/meshes/fit-lid.ply
90.0 x 41.0 x 29.0
