S9-Engineering/samsung-t-series-bay/(list of files, cad)

Other CAD files:
verification/slicing/full-kit/full-kit-geometry.3mf
verification/slicing/stop/stop-geometry.3mf
cad/cartridge-stop.step
print/slicer/lid-ecc2-pla-basic.3mf
verification/meshes/lid.ply
print/slicer/both-ecc2-pla-basic.3mf
verification/meshes/locking-pin.ply
print/slicer/stop-ecc2-pla-basic.3mf
verification/meshes/cartridge-t7-shield.ply
cad/lid.step
verification/meshes/cartridge-t7.ply
cad/coupon-lid.step
verification/meshes/shell.ply
cad/coupon-shell.step
verification/meshes/cartridge-t9.ply
cad/print/cartridge-stop.step
cad/print/cartridge-t7-shield.step
cad/print/cartridge-t7.step
cad/print/cartridge-t9.step
cad/print/lid.step
cad/print/locking-pin.step
cad/shell.step
print/stl/cartridge-stop.stl
print/stl/cartridge-t7-shield.stl
print/stl/cartridge-t7.stl
print/stl/cartridge-t9.stl
print/stl/coupon-lid.stl
print/stl/coupon-shell.stl
print/stl/lid.stl
print/stl/locking-pin.stl
print/stl/shell.stl
