S9-Engineering/samsung-t-series-bay/previews/assembly/01-fit-coupon.png

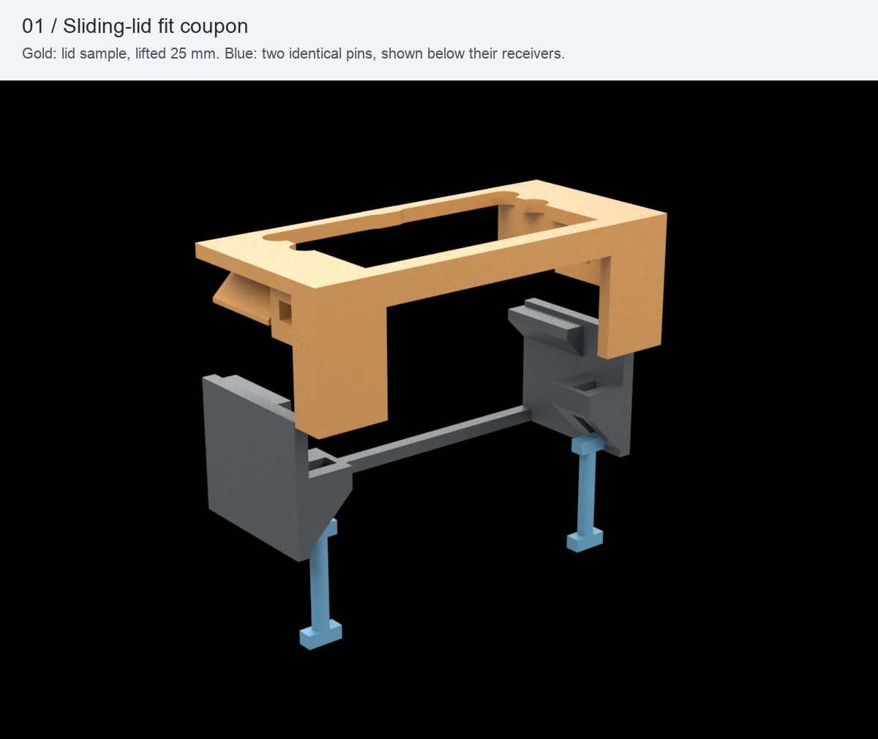
previews/assembly/01-fit-coupon.png
