S9-Engineering/samsung-t-series-bay/verification/slicing/both/guide-and-receiver-left-01.png

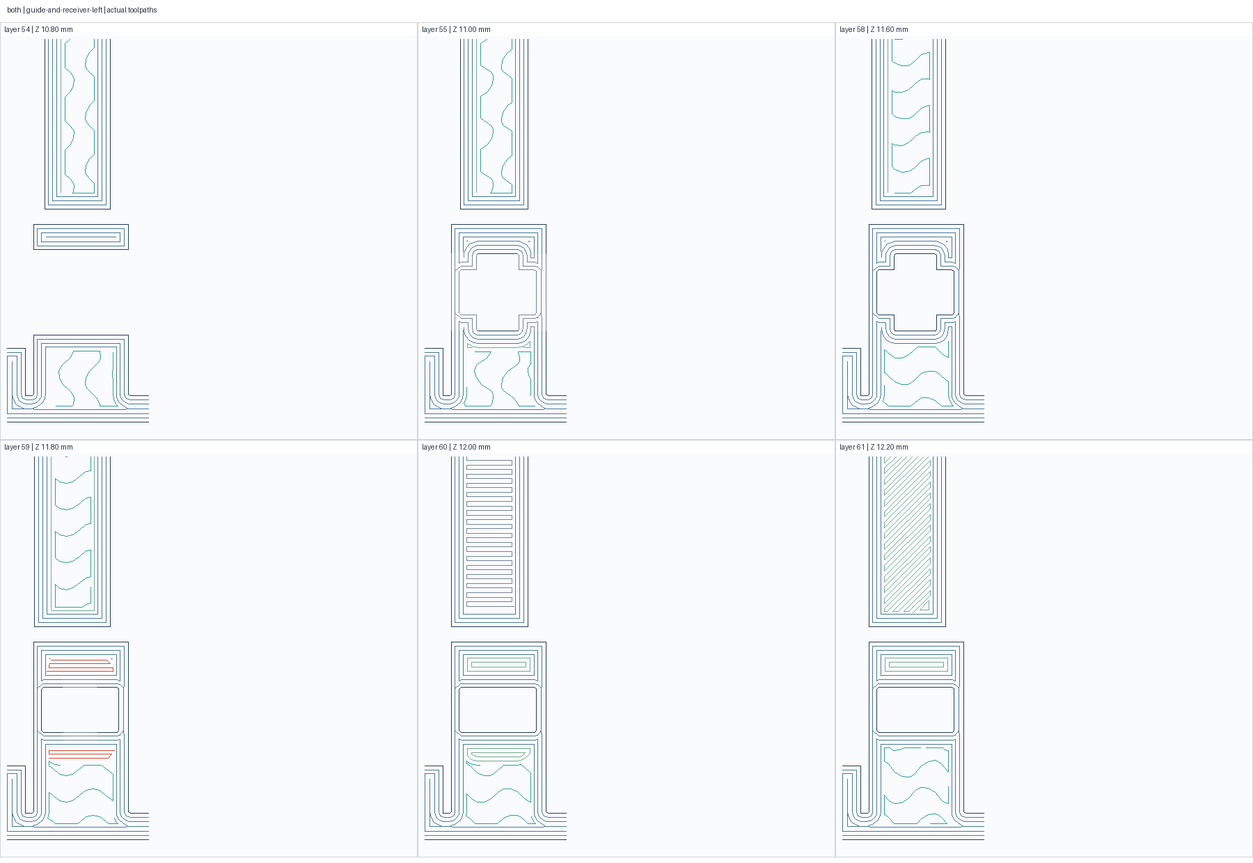
verification/slicing/both/guide-and-receiver-left-01.png
