S9-Engineering/samsung-t-series-bay/verification/slicing/both/all-layers-001-100.png

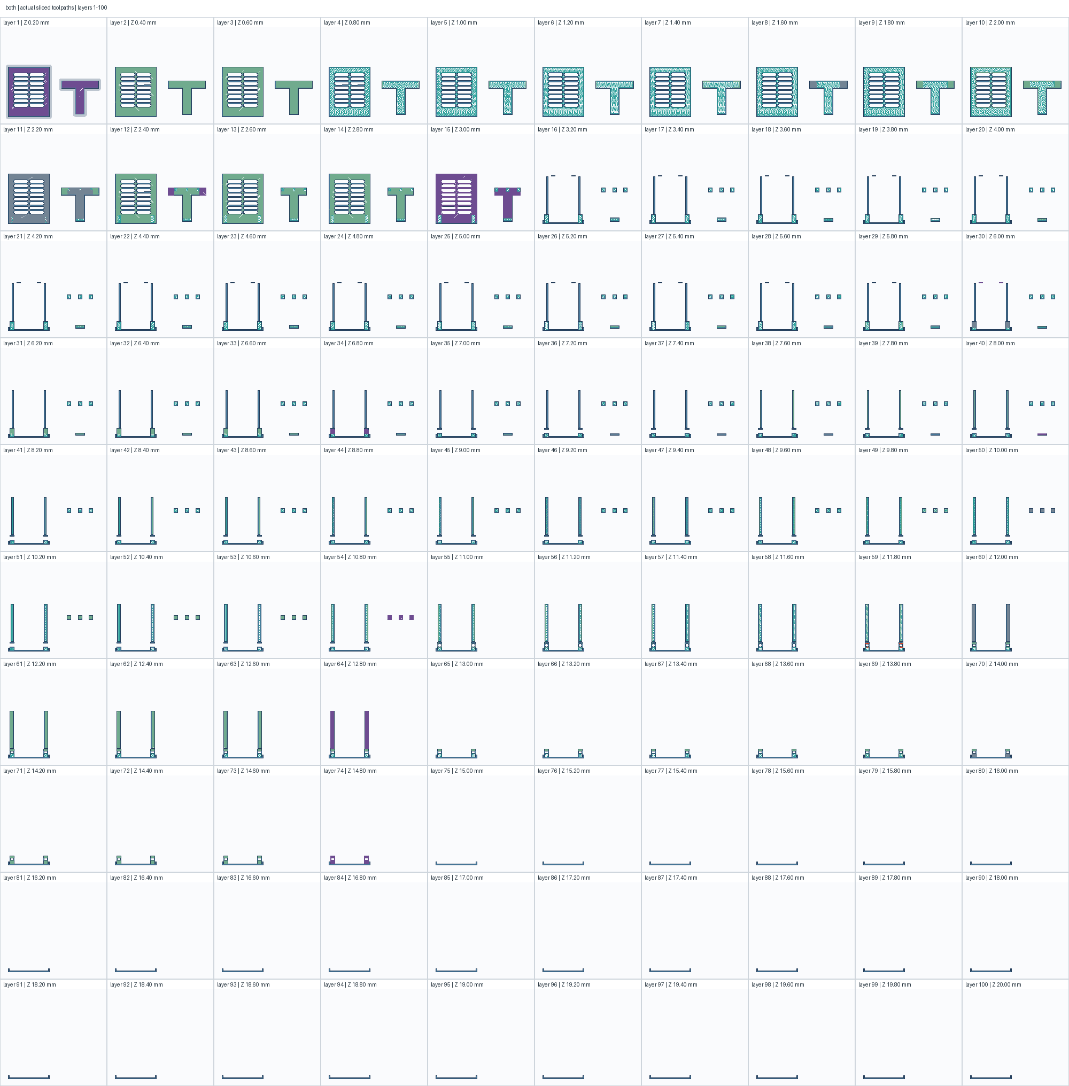
verification/slicing/both/all-layers-001-100.png
