S9-Engineering/samsung-t-series-bay/verification/slicing/both/all-layers-101-145.png

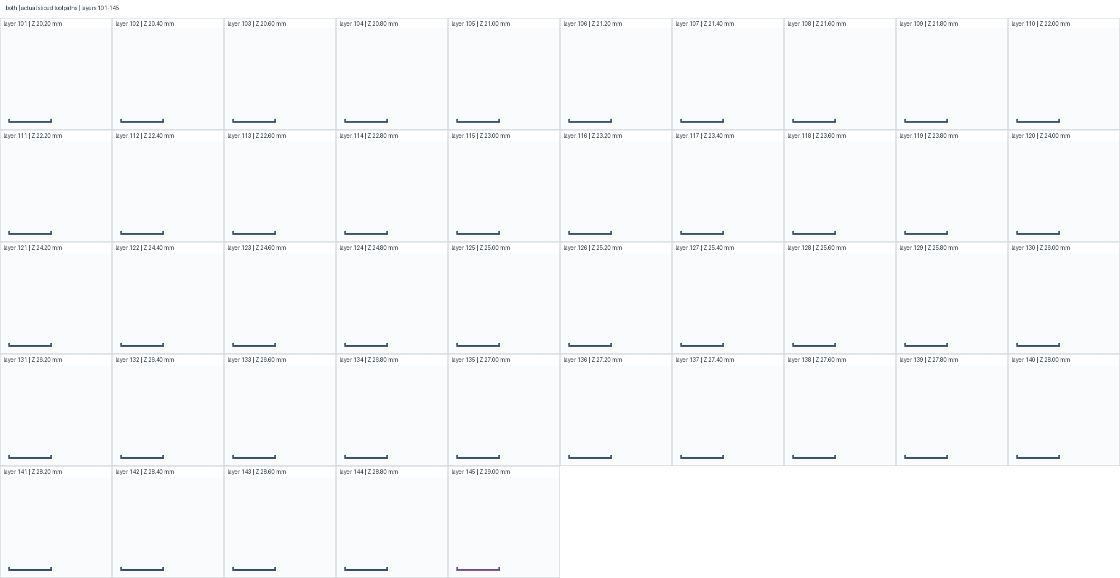
verification/slicing/both/all-layers-101-145.png
