S9-Engineering/samsung-t-series-bay/verification/slicing/both/bridge-details-01.png

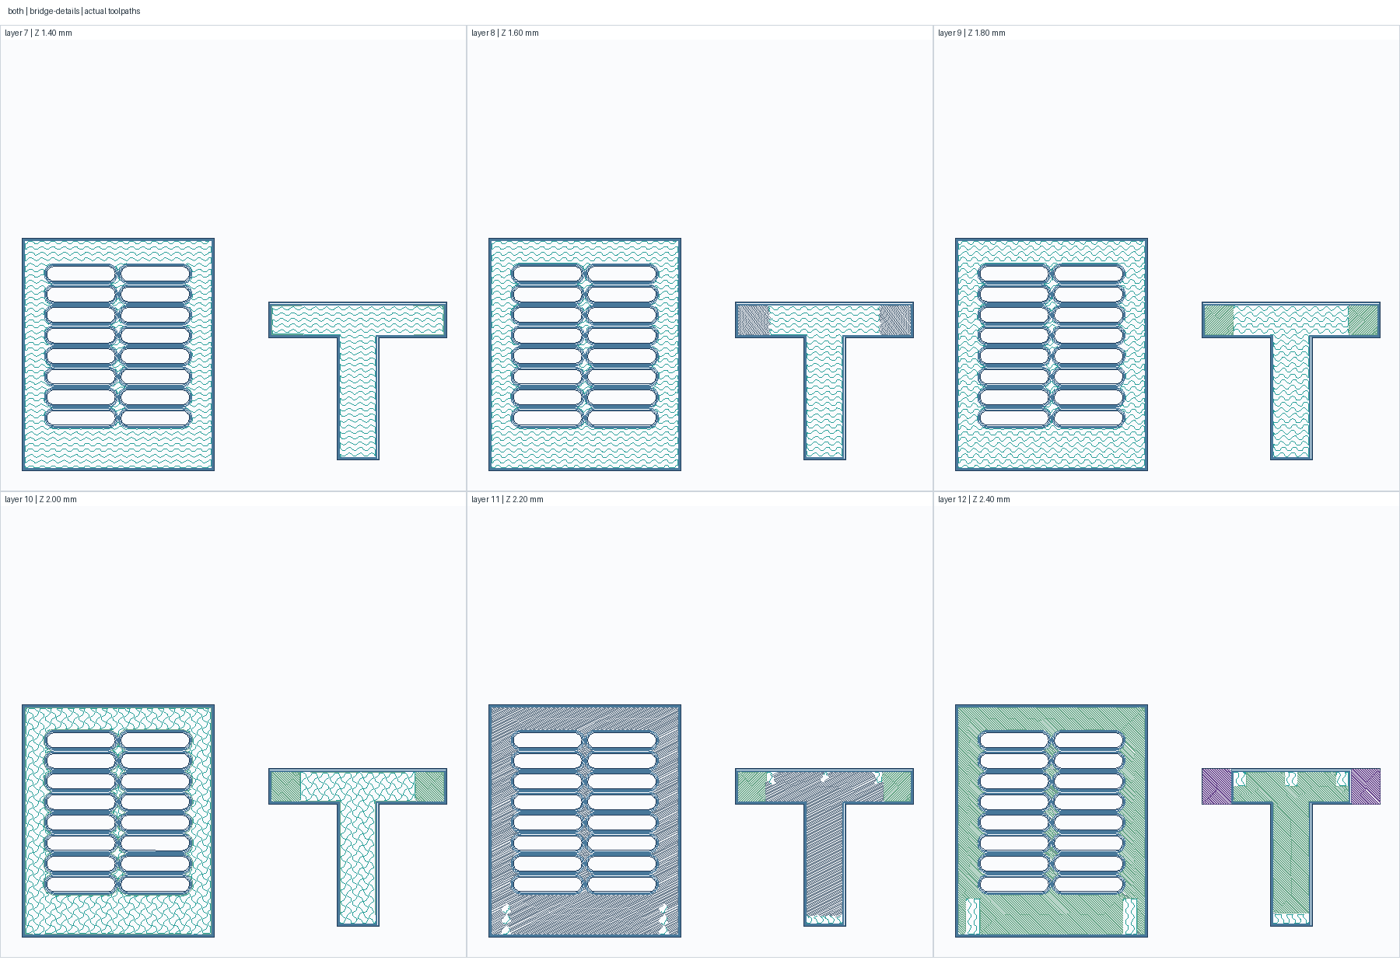
verification/slicing/both/bridge-details-01.png
