S9-Engineering/samsung-t-series-bay/verification/slicing/both/bridge-details-02.png

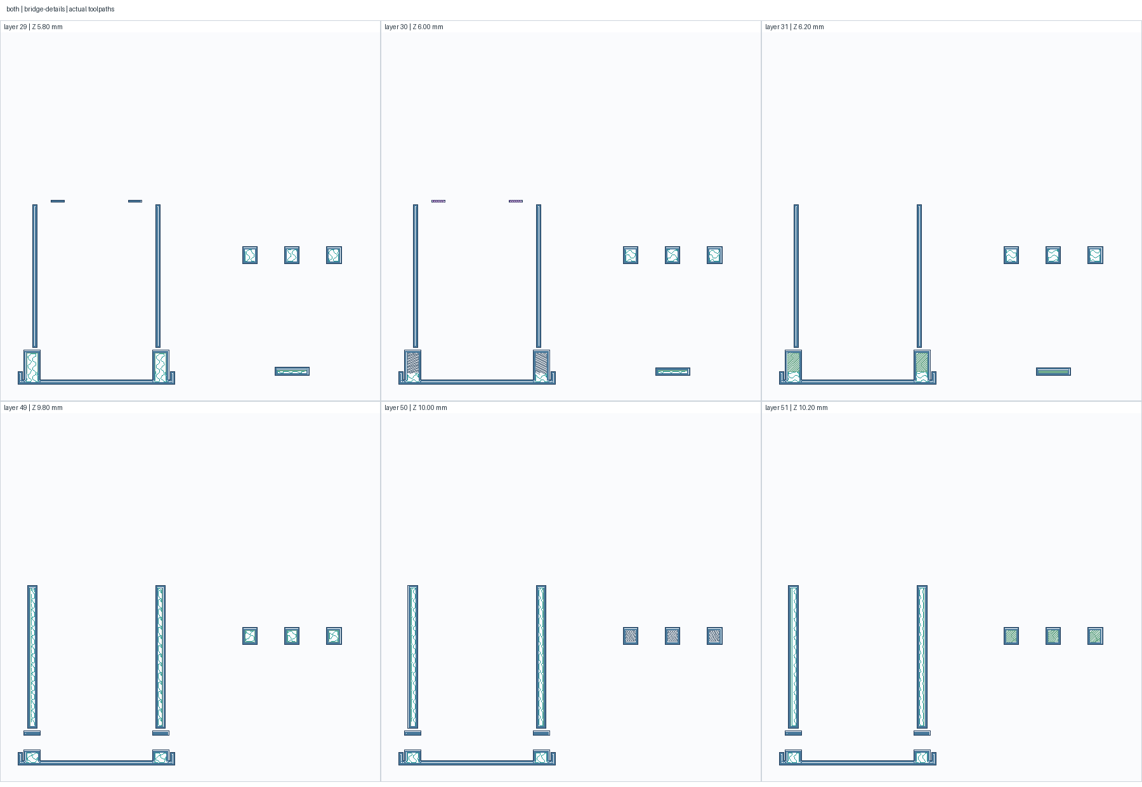
verification/slicing/both/bridge-details-02.png
