S9-Engineering/samsung-t-series-bay/verification/slicing/both/bridge-details-03.png

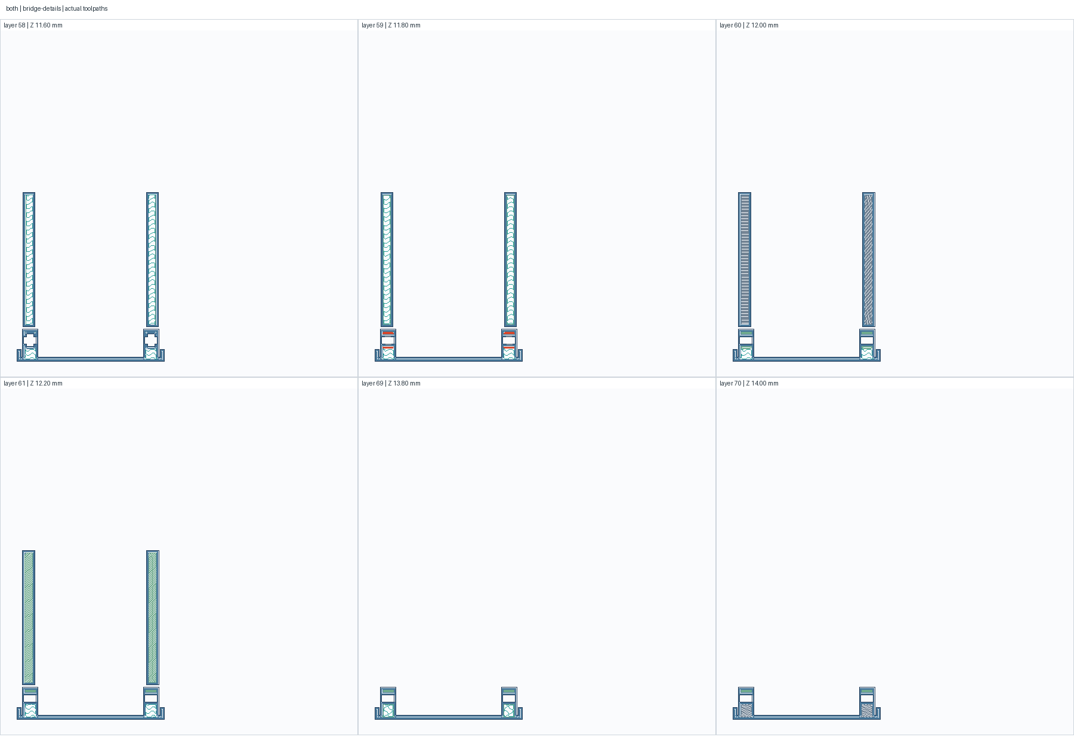
verification/slicing/both/bridge-details-03.png
