S9-Engineering/samsung-t-series-bay/verification/slicing/both/bridge-details-04.png

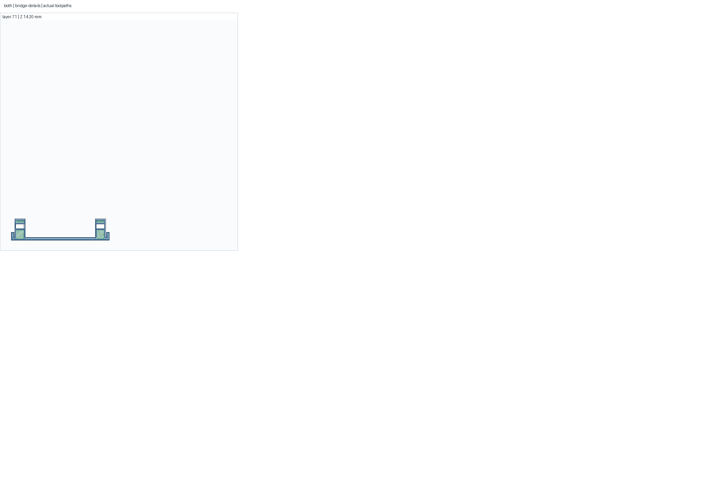
verification/slicing/both/bridge-details-04.png
