S9-Engineering/samsung-t-series-bay/verification/slicing/both/external-bridge-details-01.png

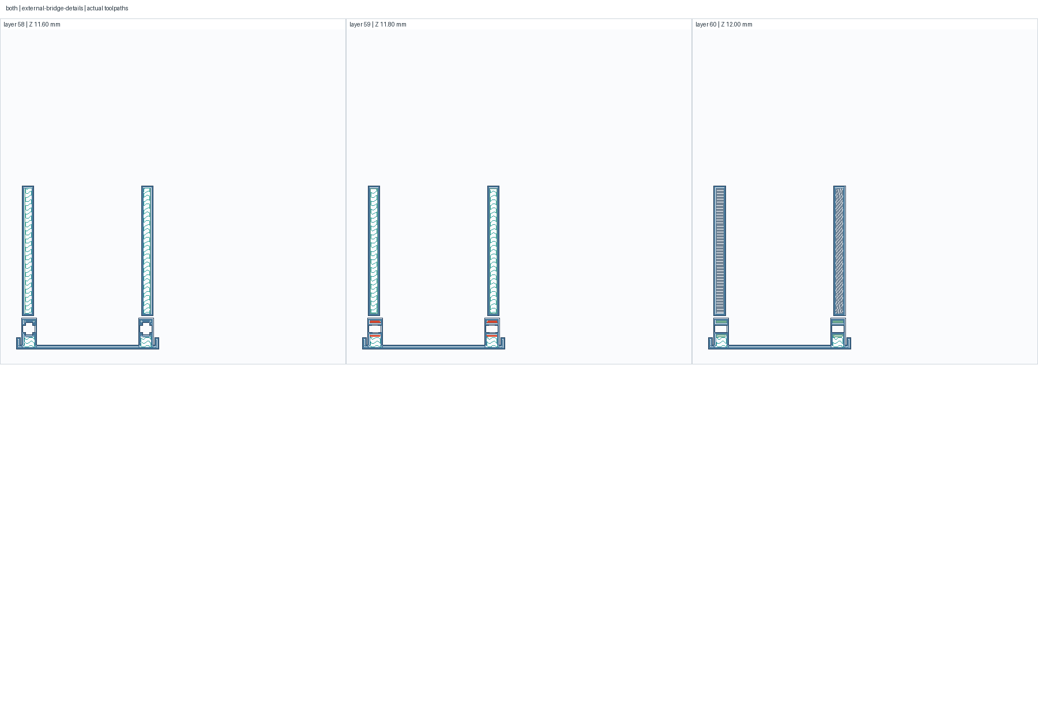
verification/slicing/both/external-bridge-details-01.png
