S9-Engineering/samsung-t-series-bay/verification/slicing/both/first-middle-last-01.png

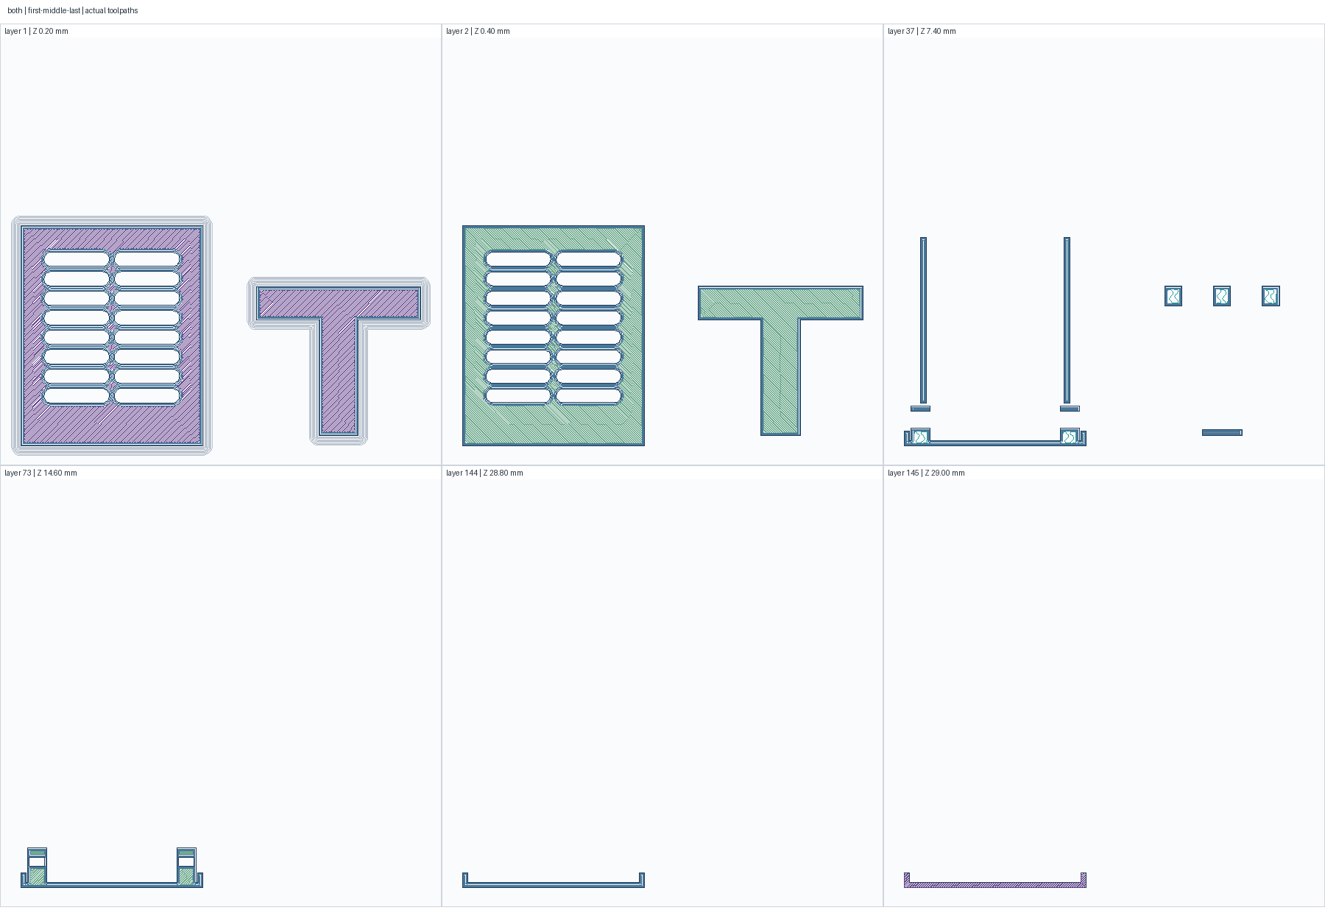
verification/slicing/both/first-middle-last-01.png
