S9-Engineering/samsung-t-series-bay/verification/slicing/full-kit/all-layers-001-100.png

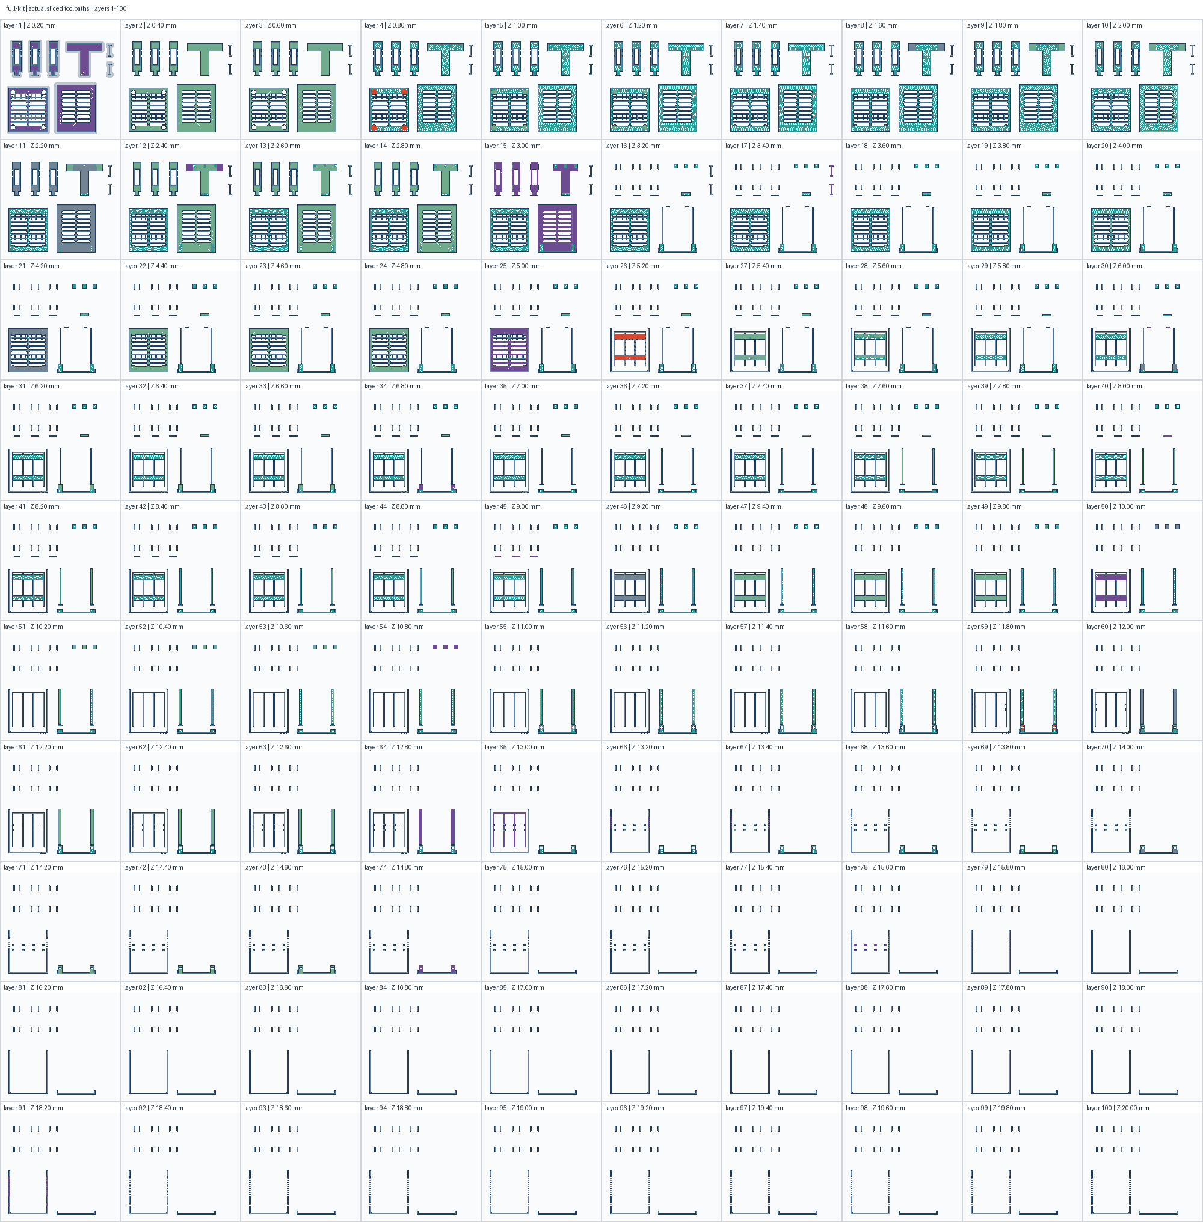
verification/slicing/full-kit/all-layers-001-100.png
