S9-Engineering/samsung-t-series-bay/verification/slicing/full-kit/all-layers-101-200.png

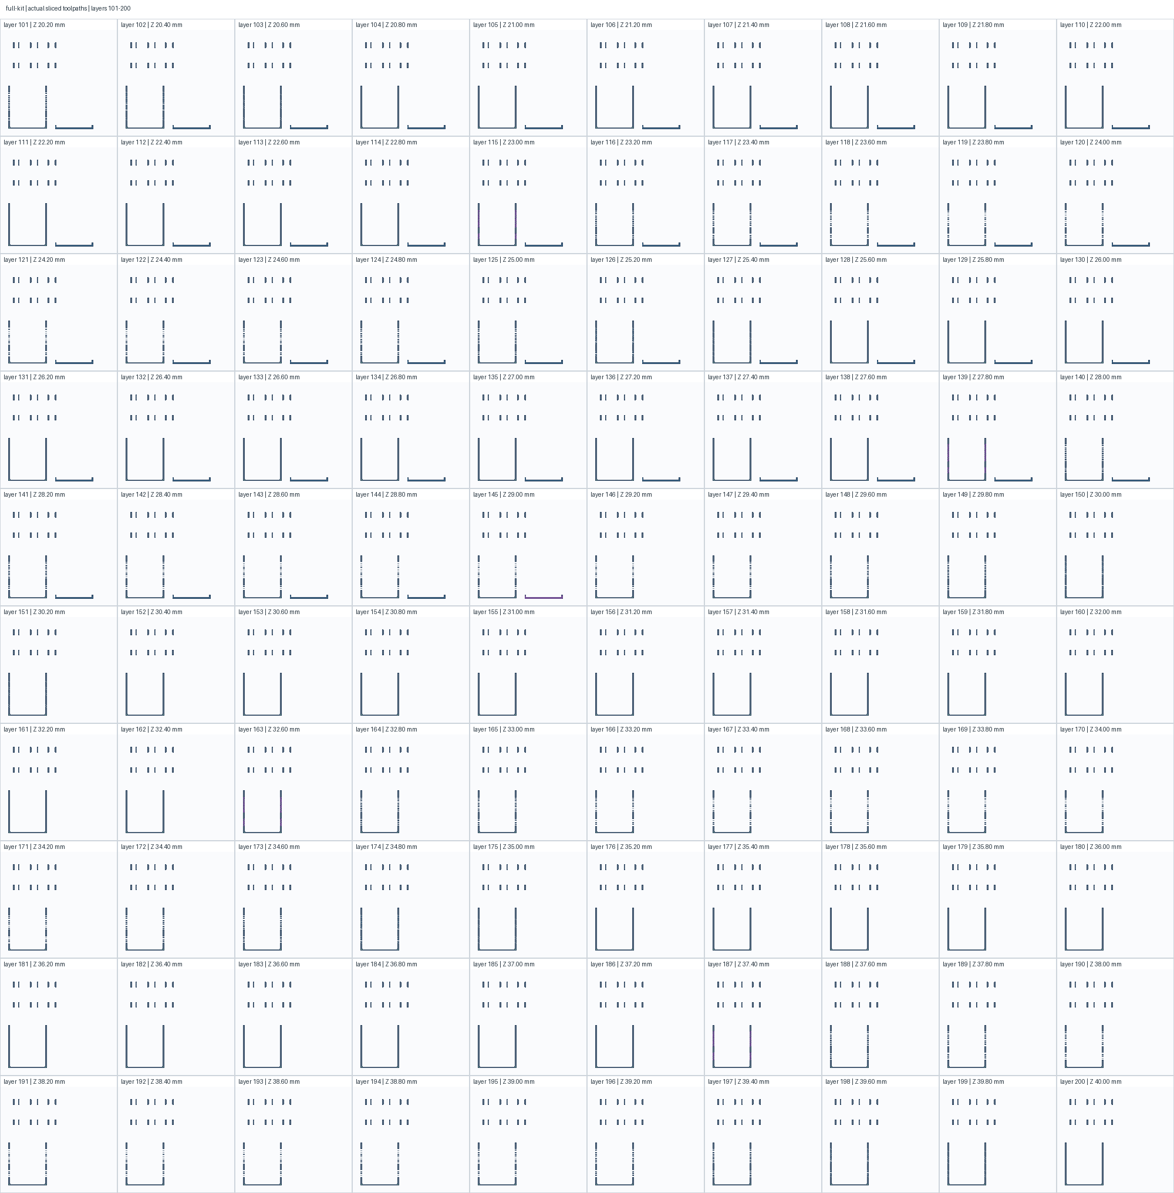
verification/slicing/full-kit/all-layers-101-200.png
