S9-Engineering/samsung-t-series-bay/verification/slicing/full-kit/all-layers-201-300.png

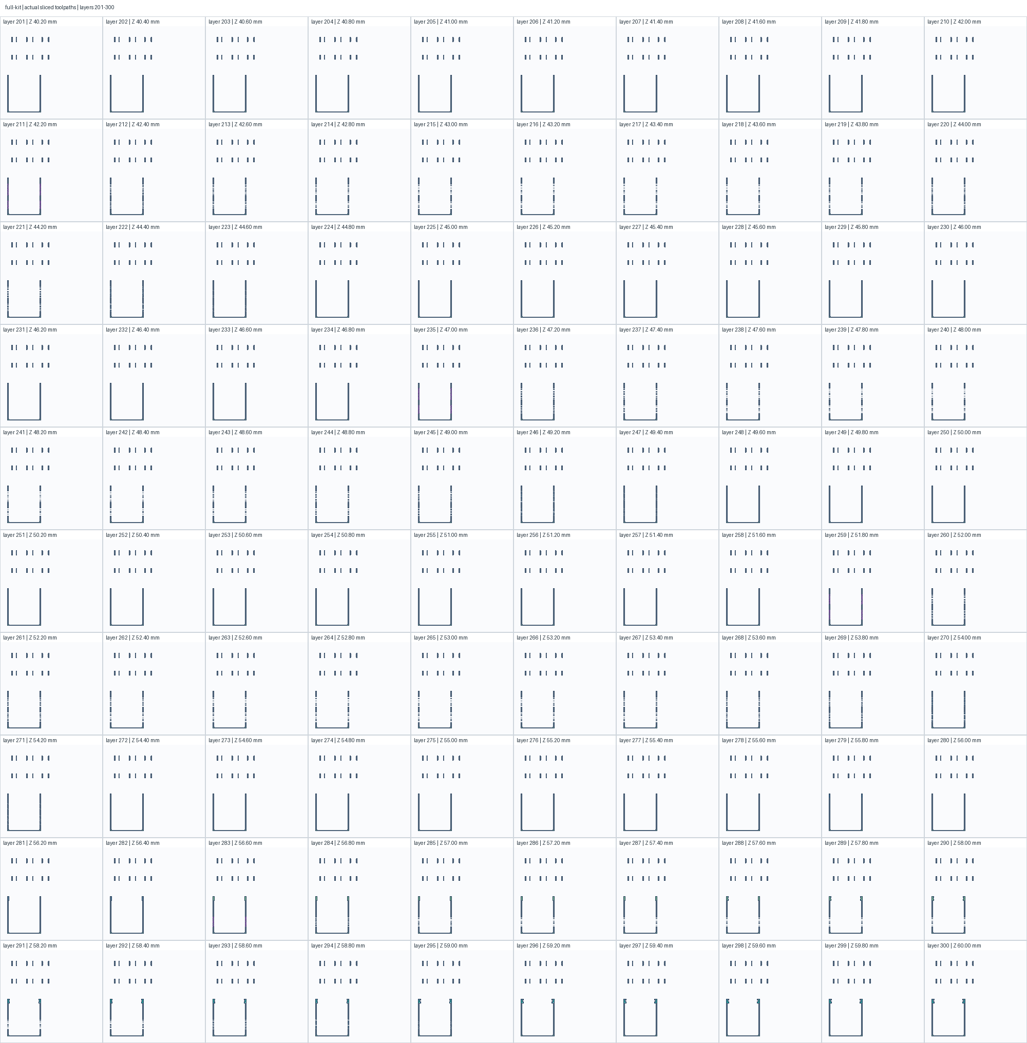
verification/slicing/full-kit/all-layers-201-300.png
