S9-Engineering/samsung-t-series-bay/verification/slicing/full-kit/all-layers-301-400.png

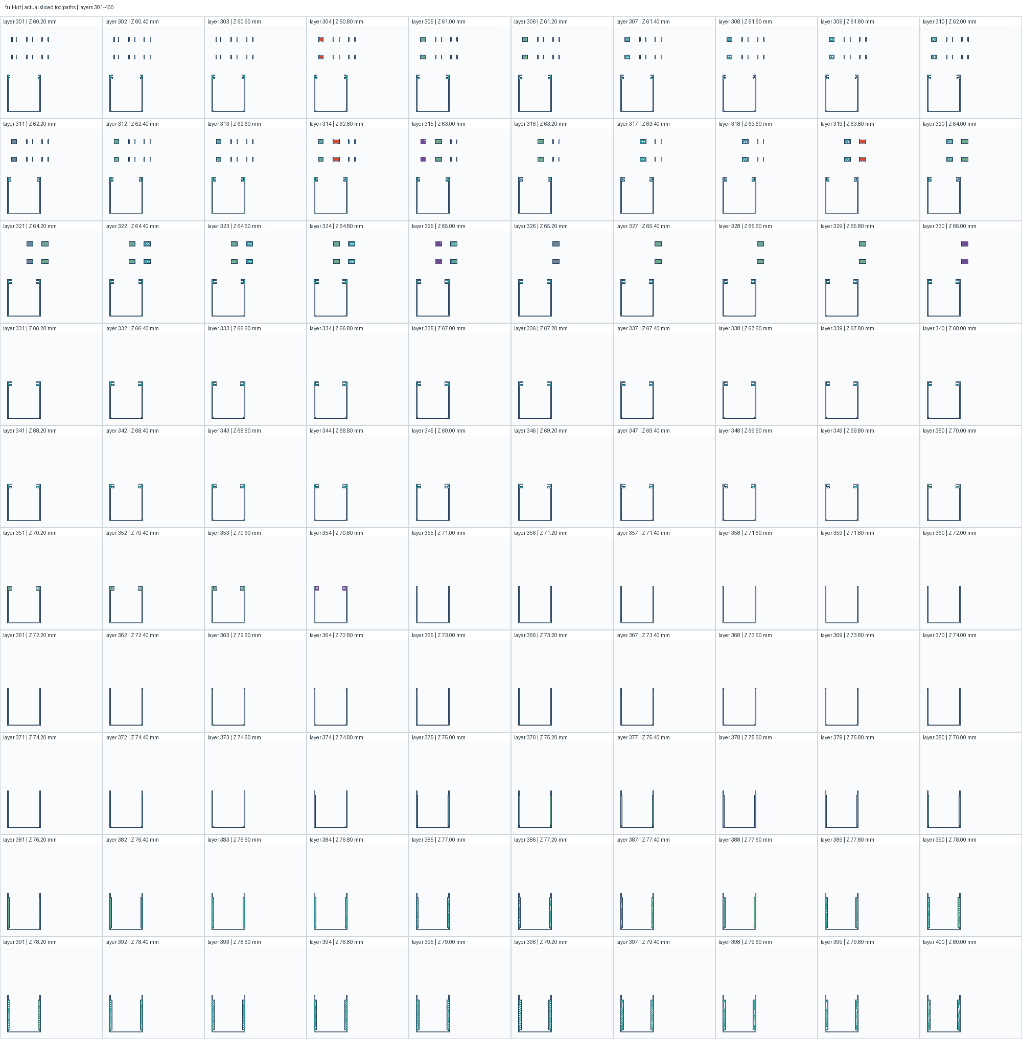
verification/slicing/full-kit/all-layers-301-400.png
