S9-Engineering/samsung-t-series-bay/verification/slicing/full-kit/all-layers-401-415.png

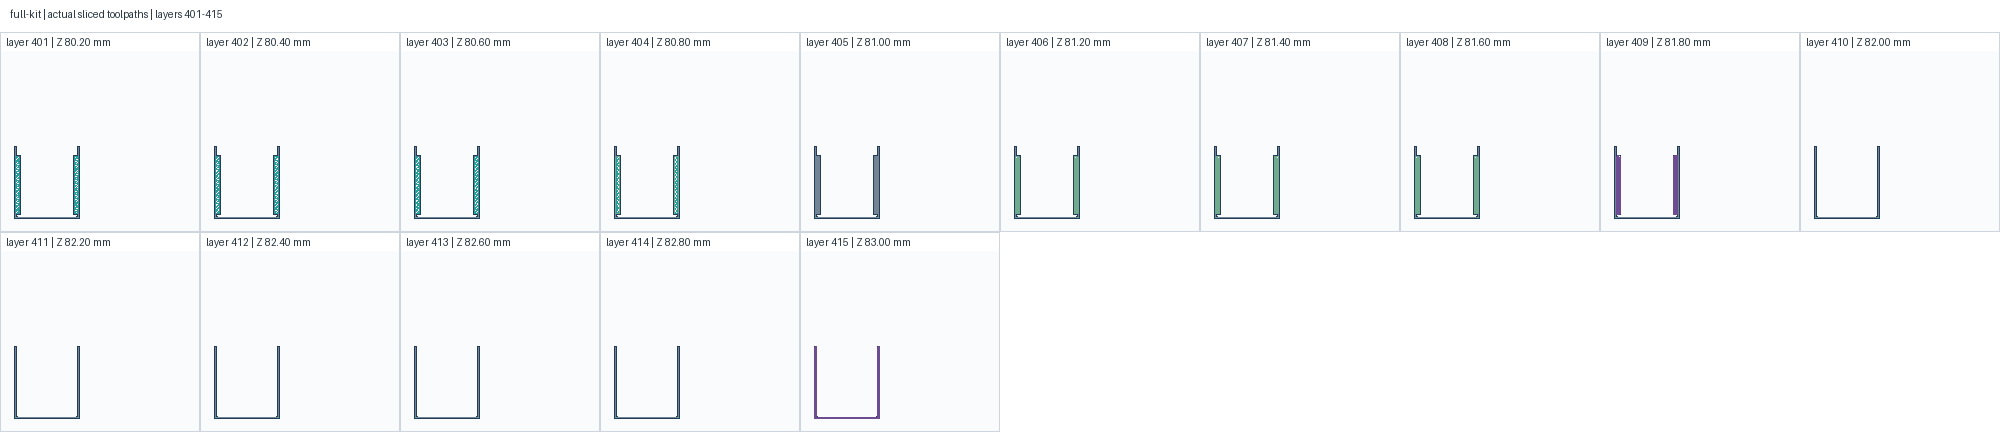
verification/slicing/full-kit/all-layers-401-415.png
