S9-Engineering/samsung-t-series-bay/verification/slicing/full-kit/bridge-details-02.png

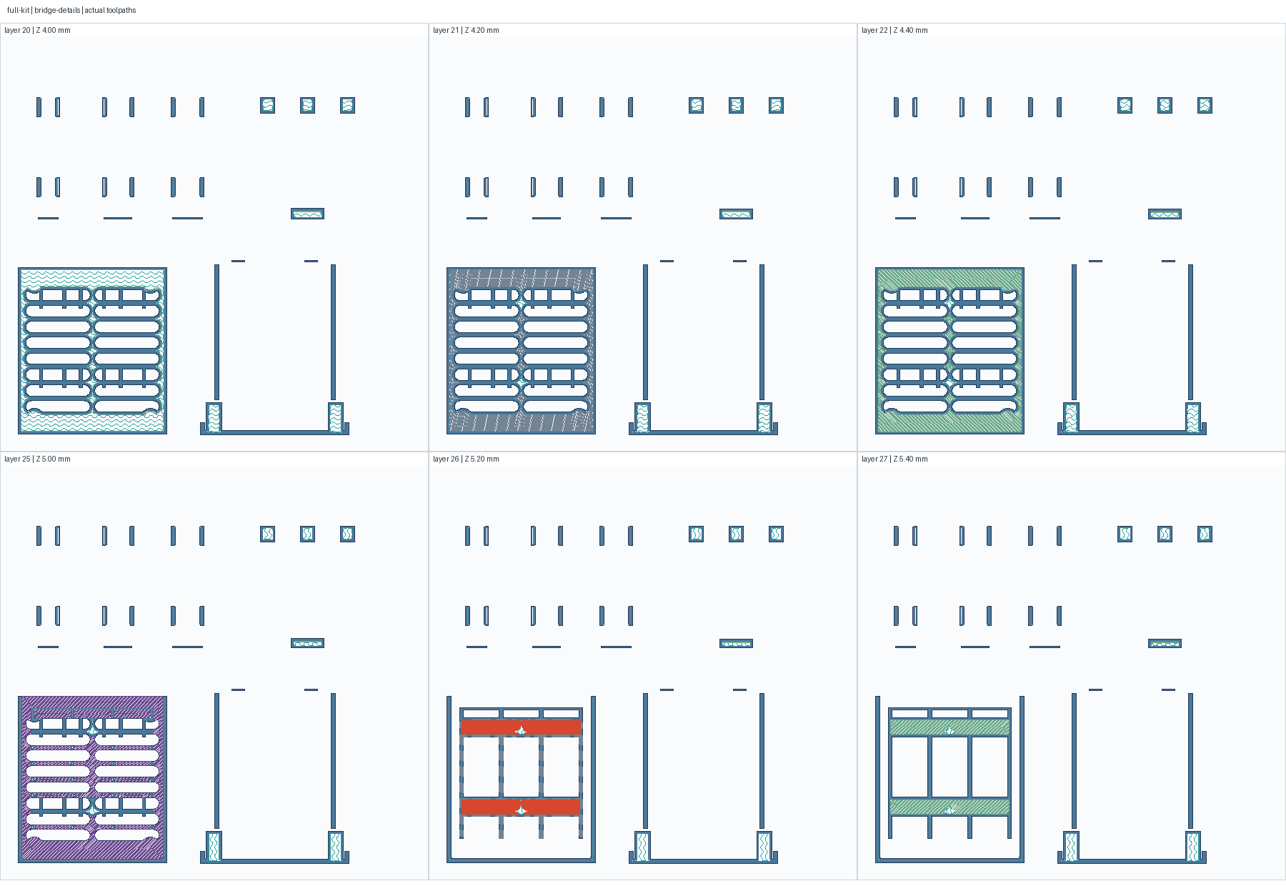
verification/slicing/full-kit/bridge-details-02.png
