S9-Engineering/samsung-t-series-bay/verification/slicing/full-kit/cartridge-bridge-t7-shield.png

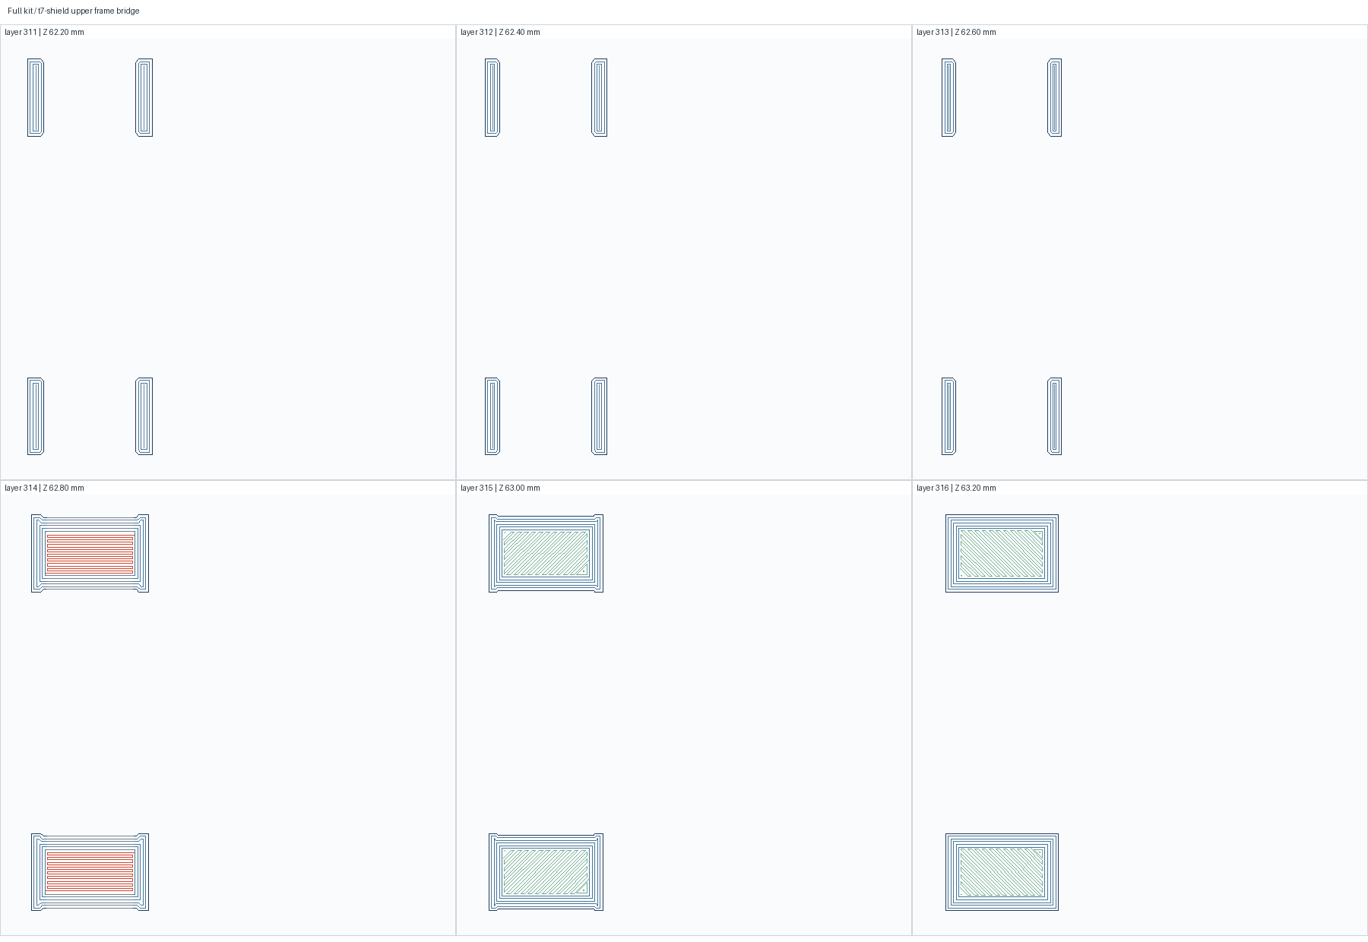
verification/slicing/full-kit/cartridge-bridge-t7-shield.png
