S9-Engineering/samsung-t-series-bay/verification/slicing/full-kit/external-bridge-details-01.png

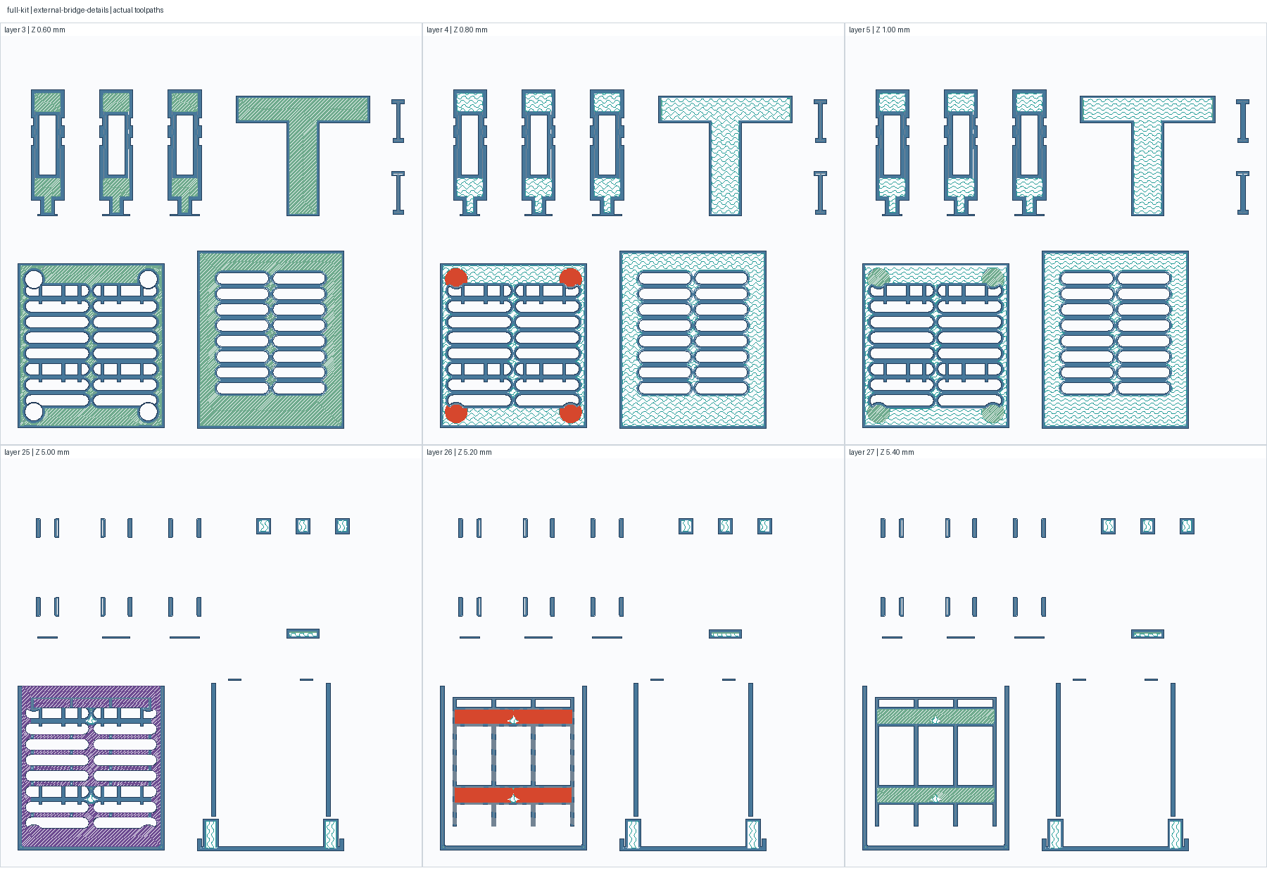
verification/slicing/full-kit/external-bridge-details-01.png
