S9-Engineering/samsung-t-series-bay/verification/slicing/full-kit/first-middle-last-01.png

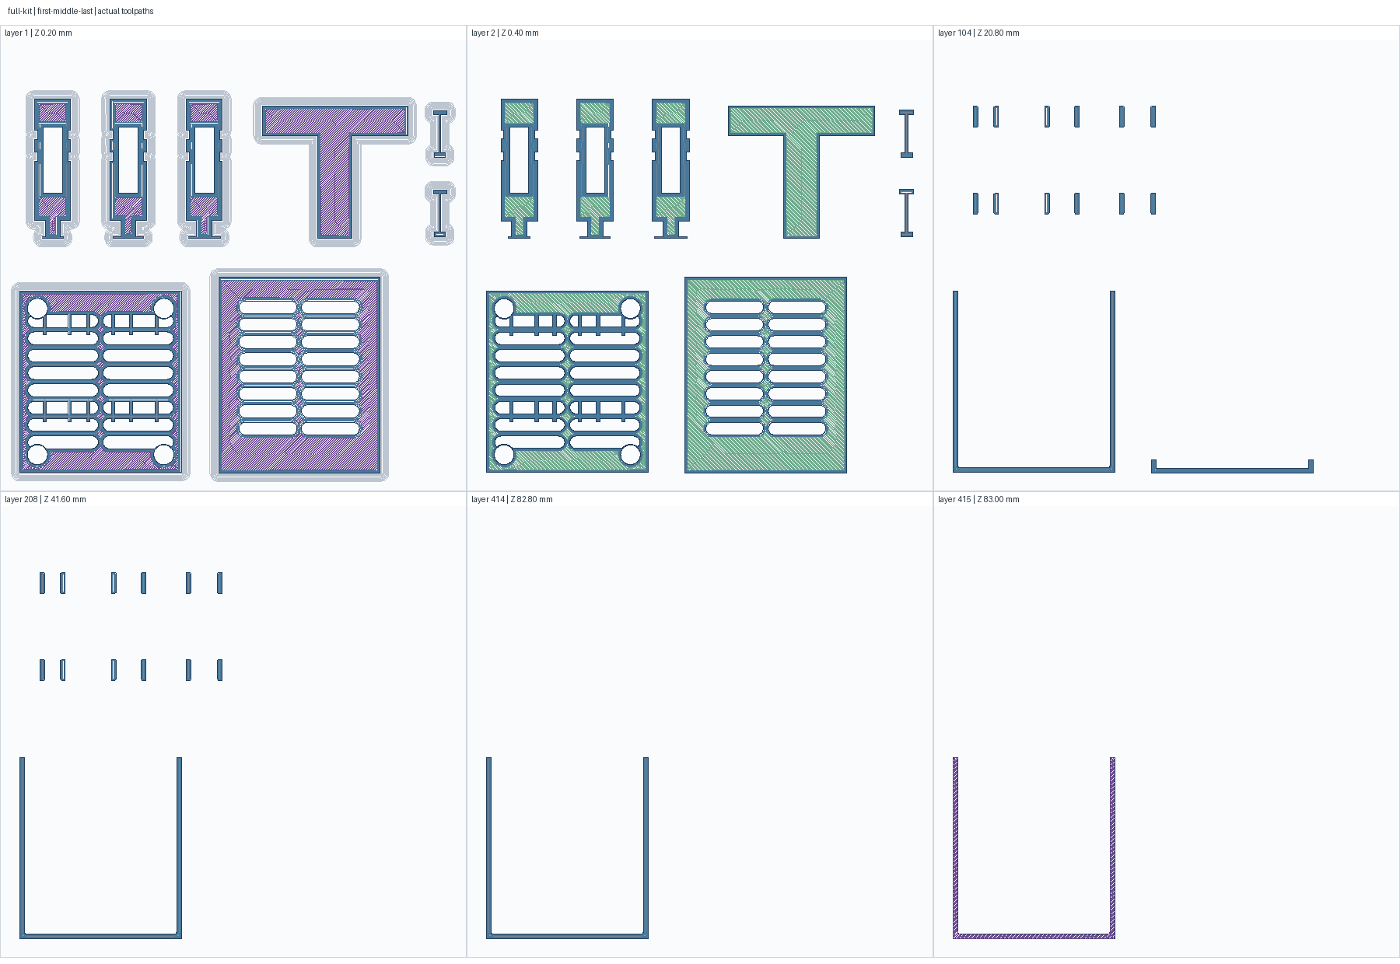
verification/slicing/full-kit/first-middle-last-01.png
