S9-Engineering/samsung-t-series-bay/verification/slicing/lid/all-layers-001-100.png

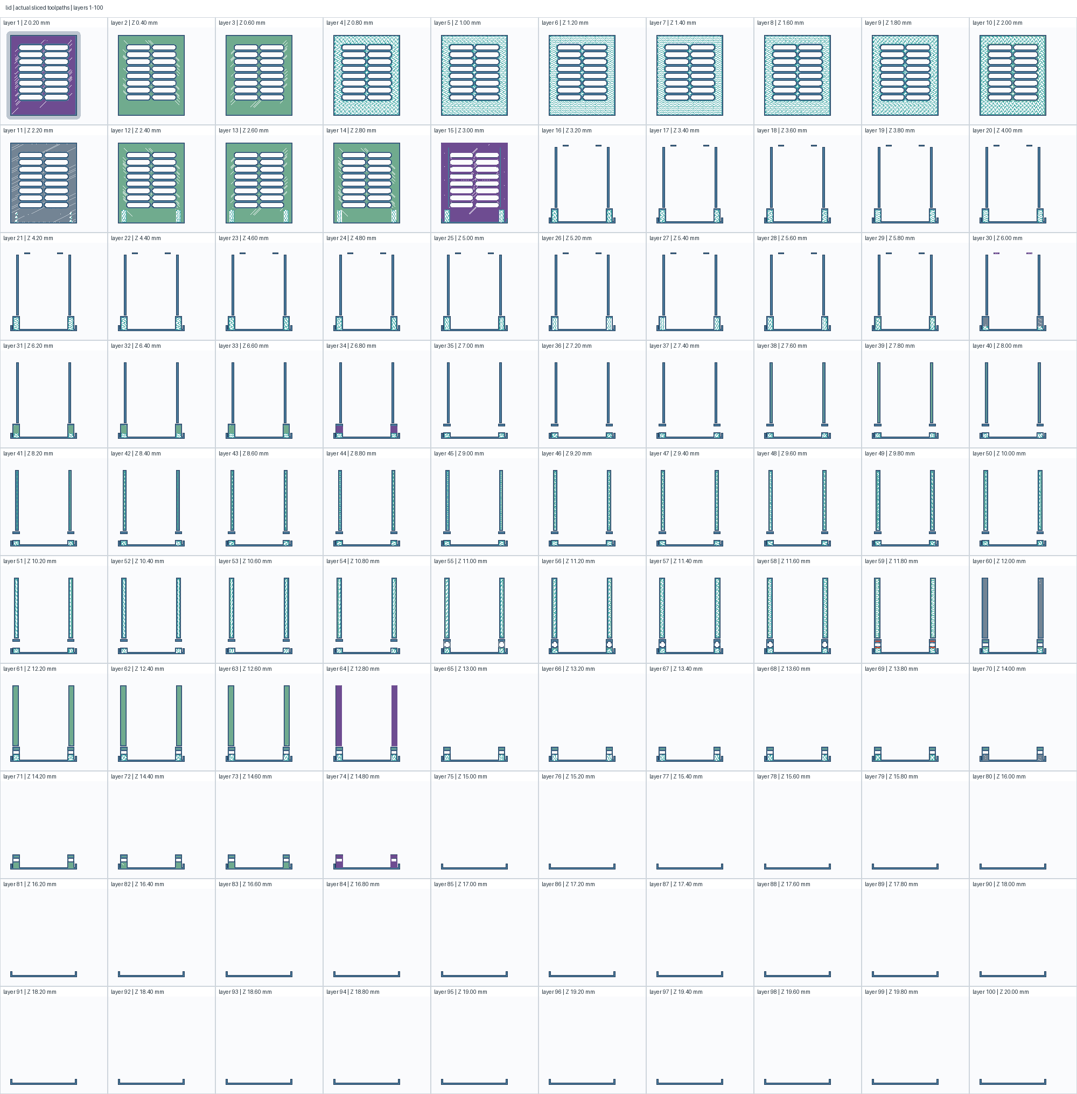
verification/slicing/lid/all-layers-001-100.png
