S9-Engineering/samsung-t-series-bay/verification/slicing/lid/all-layers-101-145.png

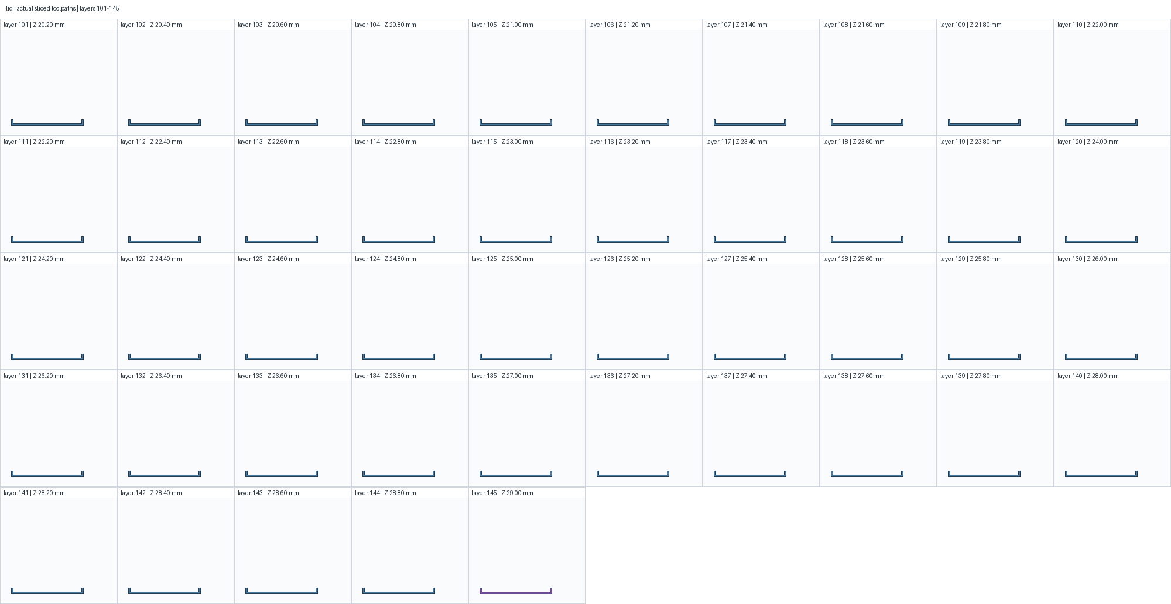
verification/slicing/lid/all-layers-101-145.png
