S9-Engineering/samsung-t-series-bay/verification/slicing/lid/bridge-details-01.png

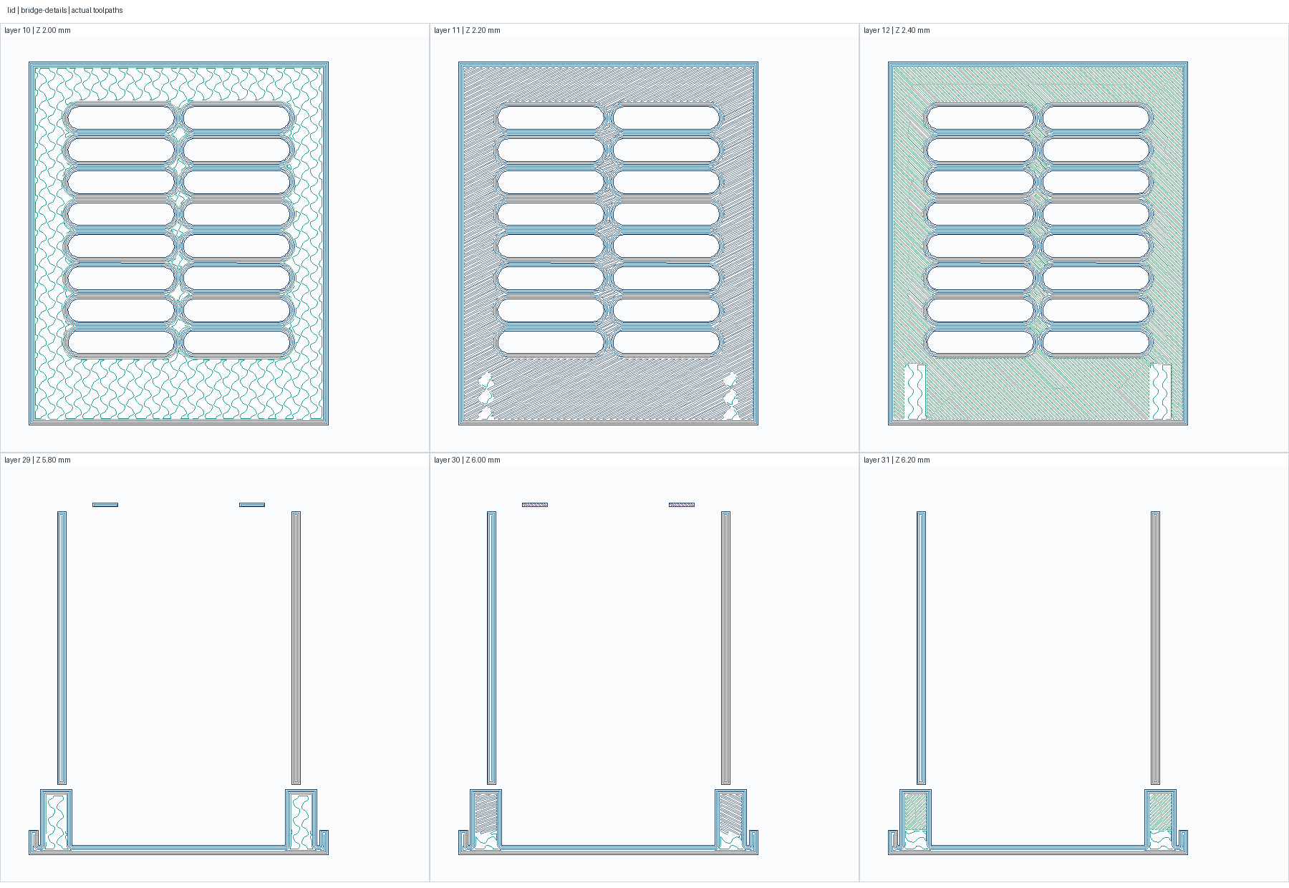
verification/slicing/lid/bridge-details-01.png
