S9-Engineering/samsung-t-series-bay/verification/slicing/lid/bridge-details-02.png

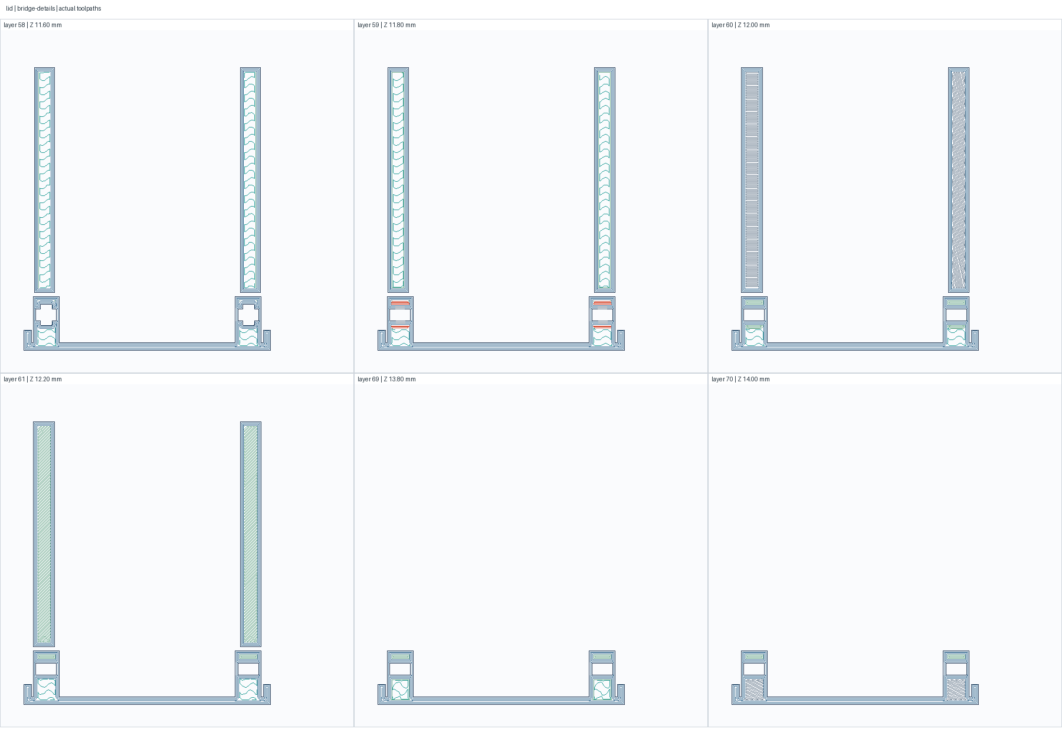
verification/slicing/lid/bridge-details-02.png
