S9-Engineering/samsung-t-series-bay/verification/slicing/lid/external-bridge-details-01.png

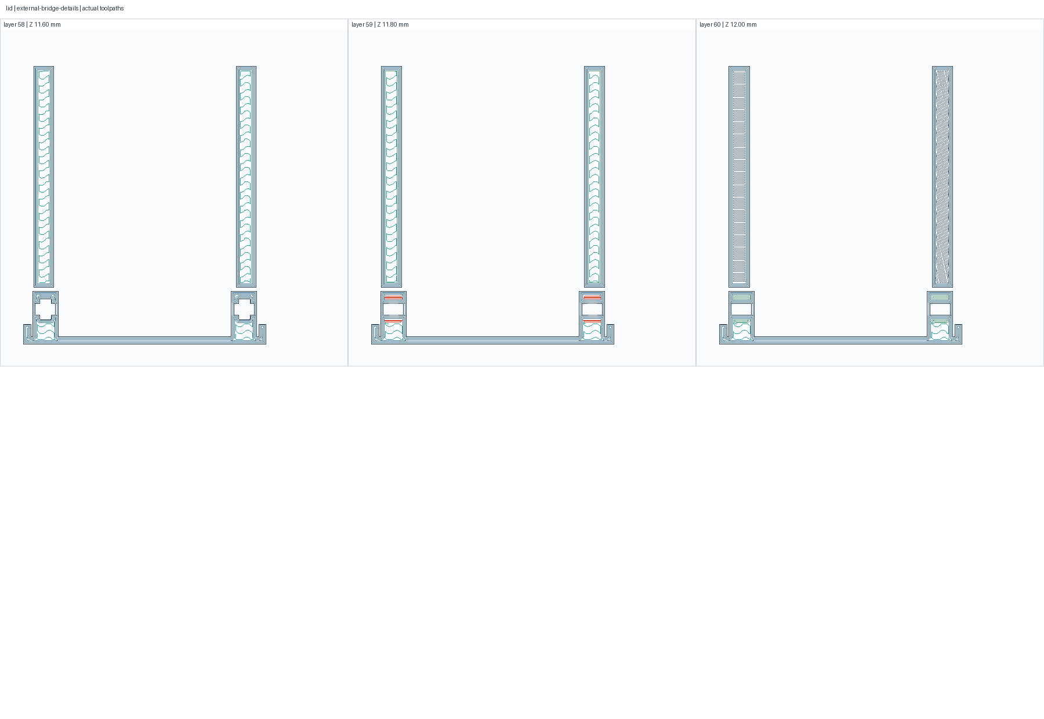
verification/slicing/lid/external-bridge-details-01.png
