S9-Engineering/samsung-t-series-bay/verification/slicing/lid/first-middle-last-01.png

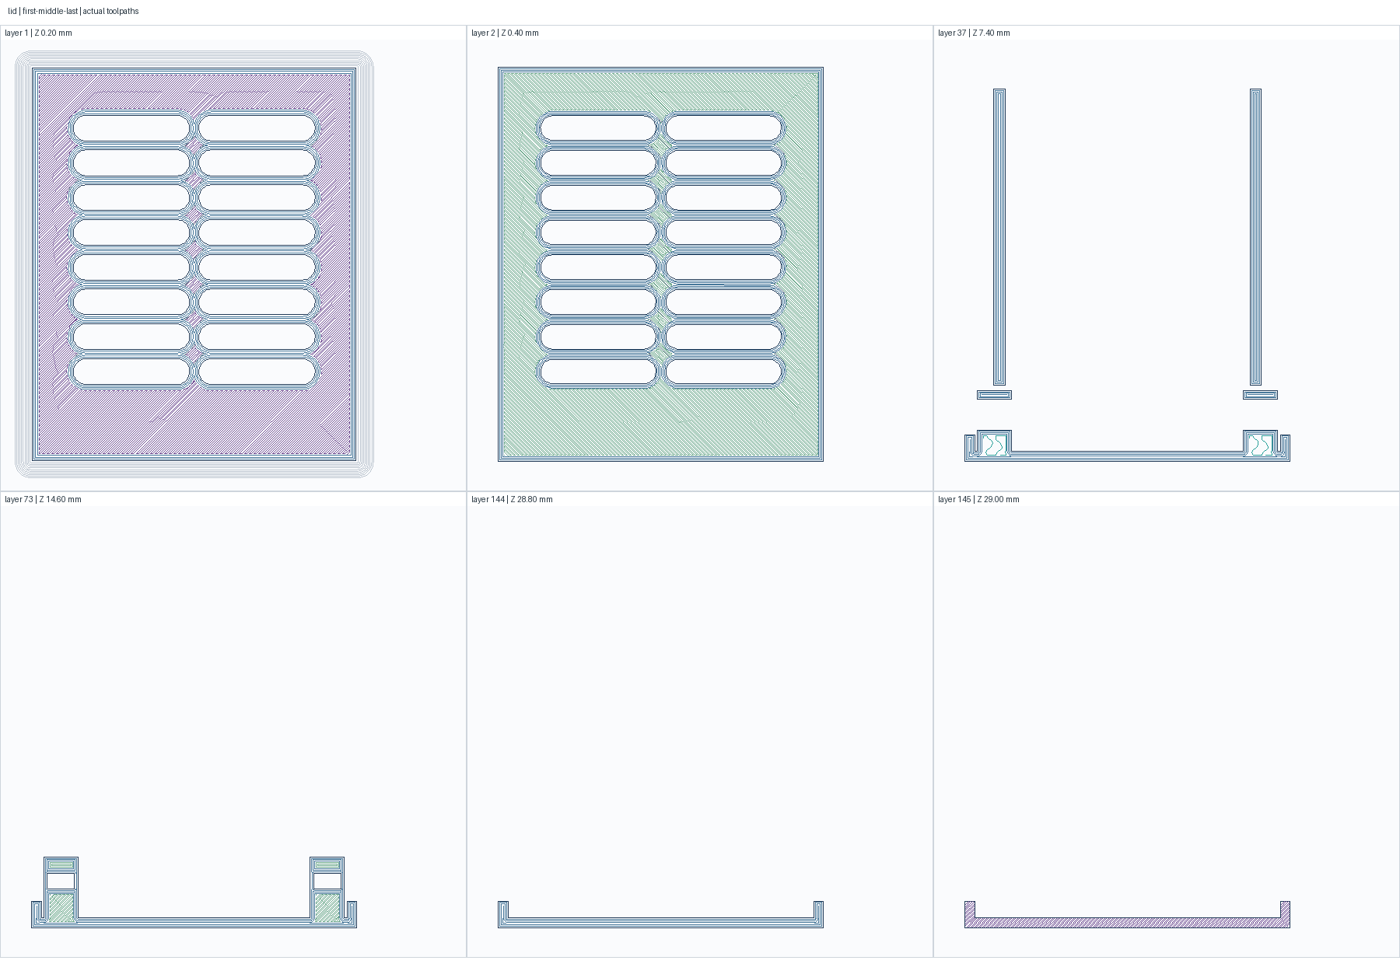
verification/slicing/lid/first-middle-last-01.png
