S9-Engineering/samsung-t-series-bay/verification/slicing/stop/all-layers-001-054.png

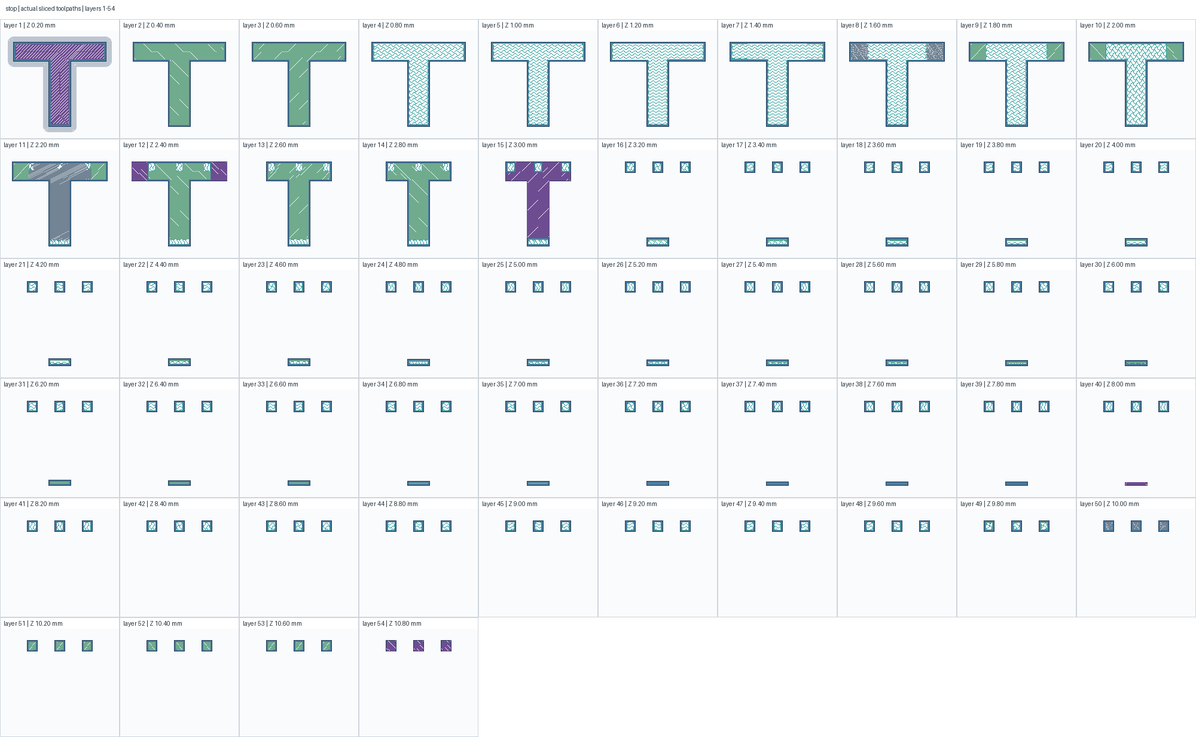
verification/slicing/stop/all-layers-001-054.png
