S9-Engineering/samsung-t-series-bay/verification/slicing/stop/bridge-details-01.png

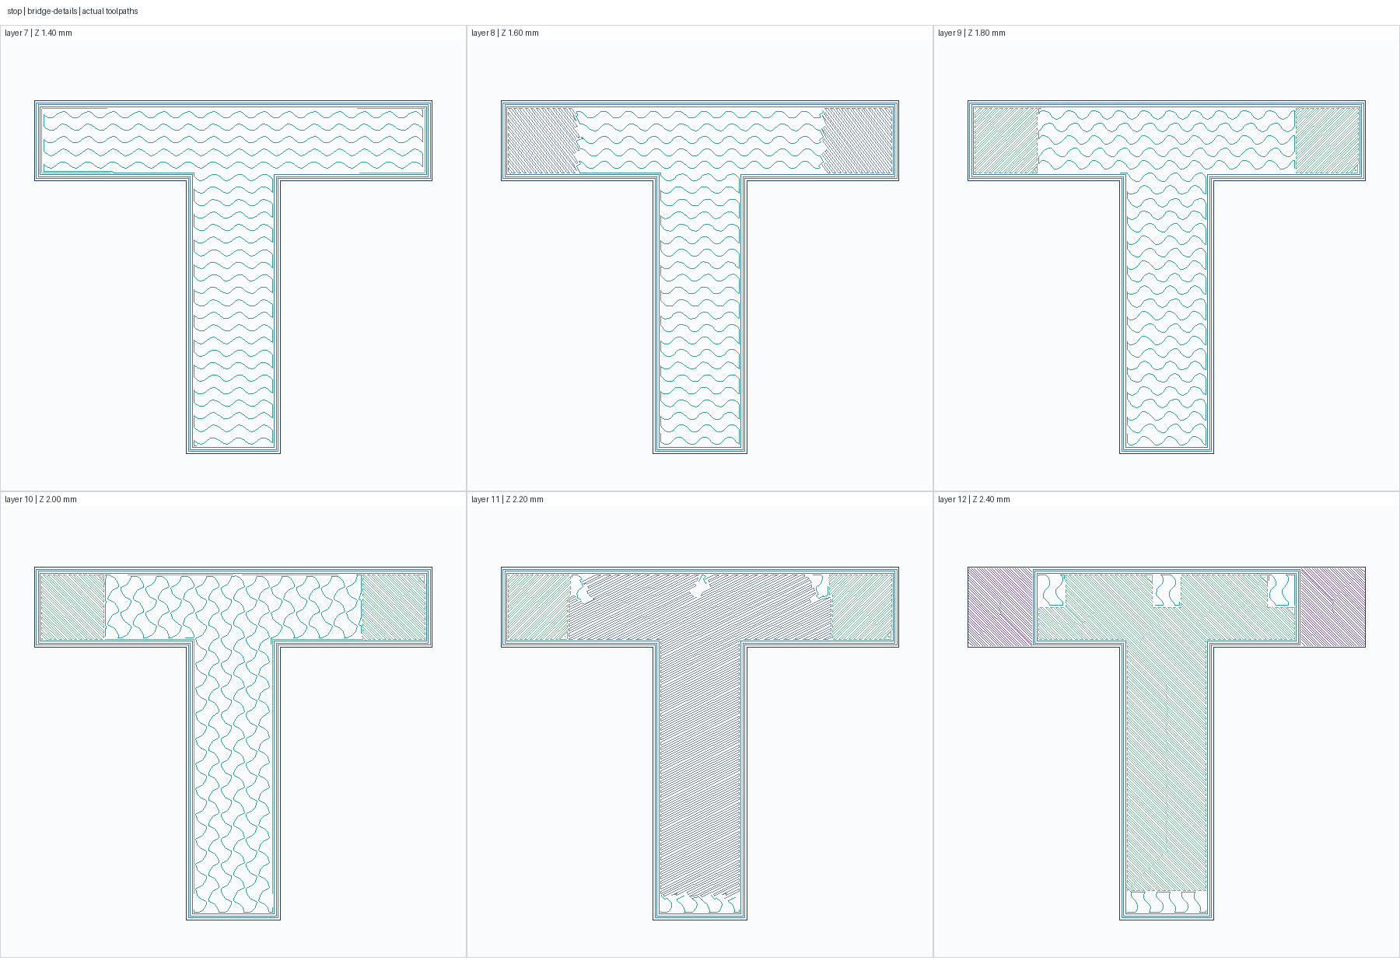
verification/slicing/stop/bridge-details-01.png
