S9-Engineering/samsung-t-series-bay/verification/slicing/stop/first-middle-last-01.png

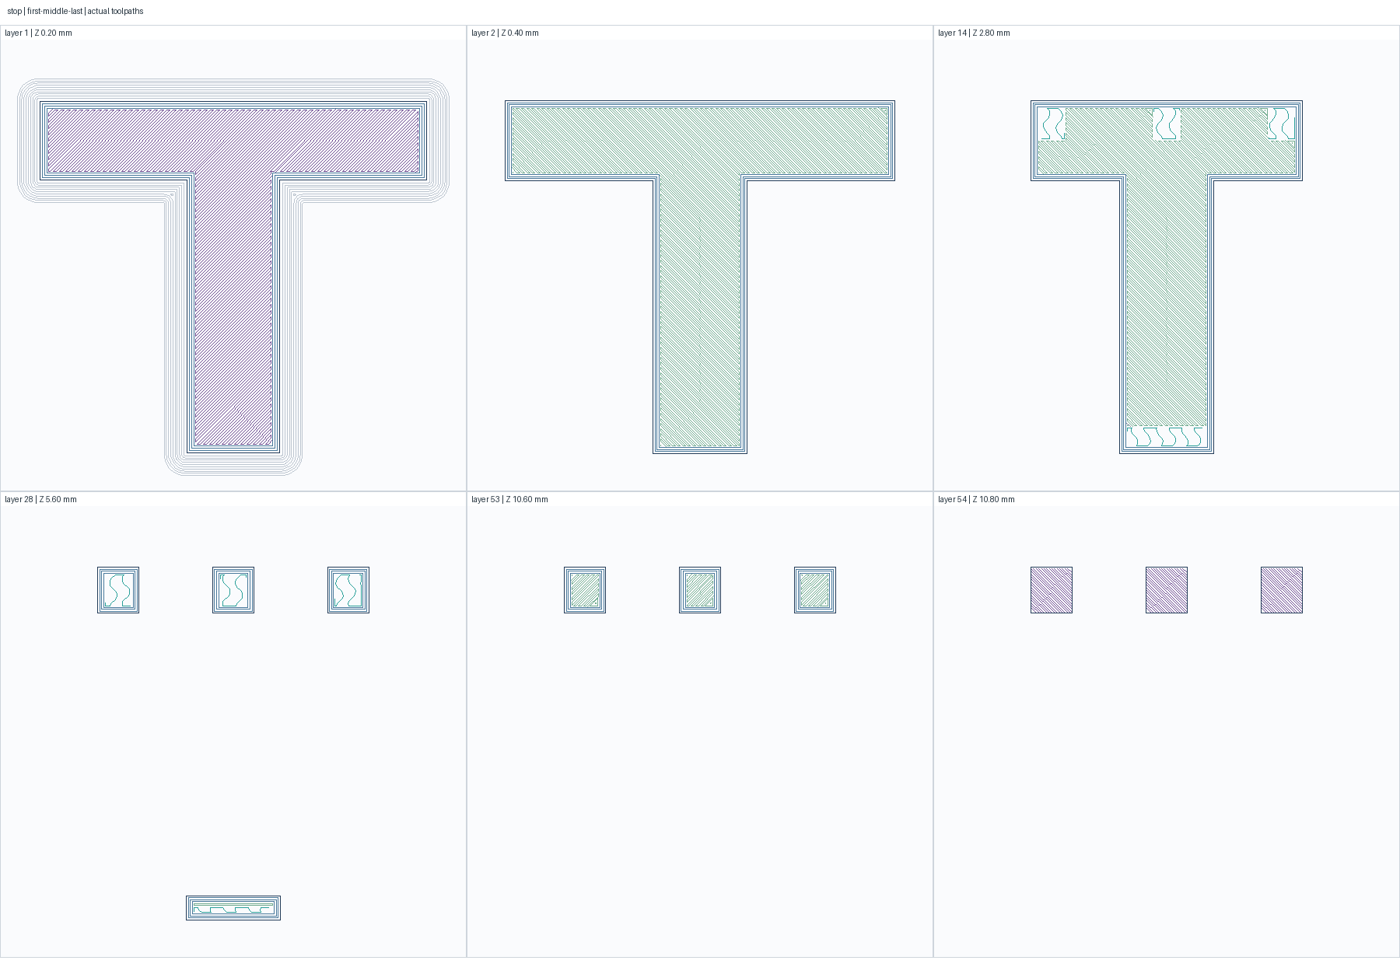
verification/slicing/stop/first-middle-last-01.png
