S9-Engineering/samsung-t-series-bay/CHANGELOG.md

# Changelog

## v1.0.2

- Add six real-print photographs to the GitHub cover/gallery, with unretouched public references and clearly labelled enhanced alternatives.
- Preserve full-resolution JPEG references and photo provenance while keeping private location metadata out of public files.
- Clarify that the photographed branded rear lid is an earlier printed part; the current downloadable lid remains plain.

Documentation and photography update only. All STL, STEP, 3MF, G-code and slicer settings are unchanged from v1.0.1.

## v1.0.1

- Widen the common cartridge stop to 83.5 mm, leaving 0.25 mm nominal clearance per side.
- Remove rear lid lettering while retaining the sliding guides, both locking pins and cable opening.
- Supply updated STL, STEP and native PLA projects, including the complete eight-part kit on one plate.
- Use one project version in VERSION, with automatic checked print releases on main pushes.

The shell, drive cartridges and both pins from v1.0.0 remain compatible. Geometry and actual slicing are checked; full-kit physical endurance and thermal validation are not claimed.

## v1.0.0

Initial published DIY 3D-printable enclosure for Samsung T7, T7 Shield and T9. Existing published assets remain unchanged.
