S9-Engineering/samsung-t-series-bay/(commit log)

2026-10-24 Release v1.0.0: Samsung T-Series Bay R27 printing package
    [01-fit-coupon-r27-ecc2-pla-basic.3mf, 02-full-kit-r27-ecc2-pla-basic.3mf, ASSIEME_A_NON_STAMPARE.step, ASSIEME_B_NON_STAMPARE.step, ASSIEME_C_NON_STAMPARE.step, ASSIEME_R22_NON_STAMPARE.step, ASSIEME_R24_NON_STAMPARE.step, ASSIEME_R25_NON_STAMPARE.step]
2026-10-24 Present S9 Monolith Bay as the complete Samsung T-Series print kit
2026-10-24 Make printing guidance brand-neutral and separate my reference setup
2026-10-24 Refine photographic cover and highlight DIY 3D printing in release presentation
2026-10-25 Preserve local wide-stop and plain-lid development before repository cleanup
    [cartridge-stop-r28-print.step, cartridge-stop-r28.ply, cartridge-stop-r28.step, cartridge-stop-r28.stl, lid-plain-r28-print.step, lid-plain-r28.ply, lid-plain-r28.step, lid-plain-r28.stl]
2026-10-25 Keep current SSD model in stable English paths and version it with Git
    [01-fit-coupon-ecc2-pla-basic.3mf, ASSIEME_A_NON_STAMPARE.step, ASSIEME_B_NON_STAMPARE.step, ASSIEME_C_NON_STAMPARE.step, ASSIEME_R22_NON_STAMPARE.step, ASSIEME_R24_NON_STAMPARE.step, ASSIEME_R25_NON_STAMPARE.step, ASSIEME_R26_NON_STAMPARE.step]
2026-10-25 Promote R28 wide cartridge stop and plain rear lid to the current print kit
    [both-ecc2-pla-basic.3mf, both-geometry.3mf, cartridge-stop.ply, cartridge-stop.step, cartridge-stop.stl, cartridge-t7-shield.step, cartridge-t7.step, cartridge-t9.step]
2026-10-25 Use one semantic project version and automate verified print releases
    [both-ecc2-pla-basic.3mf, both-geometry.3mf, cartridge-stop.step, cartridge-t7-shield.step, cartridge-t7.step, cartridge-t9.step, full-kit-ecc2-pla-basic.3mf, full-kit-geometry.3mf]
2026-10-26 Publish six real-print photographs and an unretouched GitHub gallery
